olofk/serv/(threads)

Thread 1 (2018-12-11):

trying to follow the Prerequisites instructions

maidenone, 2018-12-11:
I had to run sudo pip install fusoc, init worked fine, if i run init again, it will fail as directory is not empty.

```
maiden@Slaven2:~/Projects/serv_ws$ fusesoc library add serv ../serv
WARNING: Parse error. Ignoring file /home/maiden/Projects/serv/serv.core: Unknown item 'generate in section Root'
INFO: Interpreting sync-uri '../serv' as location for local provider.
```

```
maiden@Slaven2:~/Projects/serv_ws$  fusesoc run --target=lint serv
WARNING: Parse error. Ignoring file /home/maiden/Projects/serv/serv.core: Unknown item 'generate in section Root'
ERROR: 'serv' or any of its dependencies requires 'serv', but this core was not found
```

```
maiden@Slaven2:~/Projects/serv_ws$ fusesoc --version
1.8.4

```
```
maiden@Slaven2:~/Projects/serv$ git log
commit f52eb1931d490dabf75a7f07895a031505b9c1dc (HEAD -> master, origin/master, origin/HEAD)
Author: Olof Kindgren <olof.kindgren@gmail.com>
Date:   Sat Dec 8 00:16:35 2018 +0100

    Add info about some of serv's shortcomings

```

olofk, 2018-12-11:
Oh, my bad! I didn't realize serv is using features that aren't available in the latest released version of FuseSoC. Thanks for the detailed report. I will try to release a new version of FuseSoC soonish, but until then you can use the development version of fusesoc. Sorry for the inconvenience

    git clone https://github.com/olofk/fusesoc
    cd fusesoc
    sudo pip install -e .

maidenone, 2018-12-13:
followed your instructions, but now i get other issues...
```
maiden@Slaven2:~/Projects/serv_ws$ fusesoc library add serv ../serv
Traceback (most recent call last):
  File "/usr/local/bin/fusesoc", line 11, in <module>
    load_entry_point('fusesoc', 'console_scripts', 'fusesoc')()
  File "/usr/lib/python2.7/dist-packages/pkg_resources/__init__.py", line 484, in load_entry_point
    return get_distribution(dist).load_entry_point(group, name)
  File "/usr/lib/python2.7/dist-packages/pkg_resources/__init__.py", line 2707, in load_entry_point
    return ep.load()
  File "/usr/lib/python2.7/dist-packages/pkg_resources/__init__.py", line 2325, in load
    return self.resolve()
  File "/usr/lib/python2.7/dist-packages/pkg_resources/__init__.py", line 2331, in resolve
    module = __import__(self.module_name, fromlist=['__name__'], level=0)
  File "/home/maiden/Projects/fusesoc/fusesoc/main.py", line 16, in <module>
    from fusesoc.coremanager import CoreManager, DependencyError
  File "/home/maiden/Projects/fusesoc/fusesoc/coremanager.py", line 13, in <module>
    from fusesoc.core import Core
  File "/home/maiden/Projects/fusesoc/fusesoc/core.py", line 2, in <module>
    from fusesoc.capi2.core import Core as Capi2Core
  File "/home/maiden/Projects/fusesoc/fusesoc/capi2/core.py", line 15, in <module>
    from edalize import get_edatools
ImportError: No module named edalize
```
and

```
maiden@Slaven2:~/Projects/serv_ws$ pip install edalize
Requirement already satisfied: edalize in /usr/local/lib/python2.7/dist-packages (0.1.1)
Requirement already satisfied: Jinja2>=2.8 in /usr/lib/python2.7/dist-packages (from edalize) (2.10)
Requirement already satisfied: pytest>=3.3.0 in /usr/lib/python2.7/dist-packages (from edalize) (3.6.4)
Requirement already satisfied: funcsigs in /usr/lib/python2.7/dist-packages (from pytest>=3.3.0->edalize) (1.0.2)
```

maidenone, 2018-12-13:
Something was fubar, this resolved my previous issues:
```
pip uninstall edalize
pip install edalize
```

running the lint fails (have no serv_0.vc):
```
maiden@Slaven2:~/Projects/serv_ws$ fusesoc run --target=lint serv
INFO: Preparing ::serv:0

verilator -f serv_0.vc
make: verilator: Command not found
make: *** [Makefile:16: Vserv_top.mk] Error 127
Traceback (most recent call last):
  File "/usr/local/bin/fusesoc", line 11, in <module>
    load_entry_point('fusesoc', 'console_scripts', 'fusesoc')()
  File "/home/maiden/Projects/fusesoc/fusesoc/main.py", line 569, in main
    args.func(cm, args)
  File "/home/maiden/Projects/fusesoc/fusesoc/main.py", line 258, in run
    flags, args.system, args.backendargs)
  File "/home/maiden/Projects/fusesoc/fusesoc/main.py", line 333, in run_backend
    backend.build()
  File "/usr/local/lib/python2.7/dist-packages/edalize/edatool.py", line 95, in build
    self.build_main()
  File "/usr/local/lib/python2.7/dist-packages/edalize/verilator.py", line 123, in build_main
    self._run_tool('make', args)
  File "/usr/local/lib/python2.7/dist-packages/edalize/edatool.py", line 252, in _run_tool
    except FileNotFoundError:
NameError: global name 'FileNotFoundError' is not defined
```

```
maiden@Slaven2:~/Projects/serv_ws$ ls build/serv_0/src/serv_0/rtl/
ser_add.v  ser_lt.v     serv_alu.v  serv_ctrl.v    serv_mem_if.v   serv_regfile.v  shift_reg.v
ser_eq.v   ser_shift.v  serv_csr.v  serv_decode.v  serv_params.vh  serv_top.v
```

building also fails:
```
maiden@Slaven2:~/Projects/serv_ws$ fusesoc run --target=verilator_tb serv --uart_baudrate=57600 --firmware=../serv/sw/zephyr_hello.hex
ERROR: Conflicting requirements:
Requirements: 'serv == 0-0' <- 'wb_ram >= 0-0' <- 'wb_common >= 0-0'
    +wb_ram-1.1-0 was ignored because it depends on missing packages
Requirements: 'serv == 0-0' <- 'wb_ram >= 0-0'
    serv-0-0 requires (+wb_ram-1.1-0)
Requirements: 'serv == 0-0'
    Install command rule (+serv-0-0)

Failed to resolve dependencies for serv
```

olofk, 2018-12-13:
Hmm... maybe it didn't get the base libraries correctly. `wb_common` should be part of the standard libs. Can you run `fusesoc list-cores` and check if you can find wb_common there, or `fusesoc core-info wb_common` and see what happens.

The quick fix would be to remove `depend = wb_common` from `cores/wb_ram_1.1/wb_ram.core` as the dependency isn't even used in this case.

Another fix would be to remove everything under `~/.local/share/fusesoc`, remove `~/.config/fusesoc/fusesoc.conf` and re-run `fusesoc init`. Since you had some problems with init initially something might be out of sync

olofk, 2022-07-25:
I'm taking the liberty to close this now because pretty much everything here is severely outdated by now

Closed 2022-07-25.

Thread 2 (2018-12-13):

background info

maidenone, 2018-12-13:
is there any good documentation/papers that you can refer to? or is it  best to just "read the code",
google gave me this: http://fpga-guru.com/files/supercn.pdf

olofk, 2018-12-13:
I would love to write some more about the core, but I'm not sure when I would have time. But the basic info is that the data is streamed through the CPU one bit per cycle starting with LSB. When the CPU boots up
`serv_ctrl.v` will request a new instruction through the `ibus` interface. `serv_decode.v` decodes the instruction into a number of control signals that are used as select inputs to muxes and similar. The data is then streamed from the registers in `serv_regfile.v` (together with an immediate that is pieced together in the decoder when applicable), through the ALU, mem interface, csr or then control unit depending on the instruciton type, and the result usually ends up in register rd in `serv_regfile.v`. The most straight-forward unit to look at might be `serv_alu` if you want to start somewhere

zwizwa, 2020-01-31:
I'm interested to take a stab at docs but I'd have to do it as part of a project to squat two flies with one hand. Currently I'm trying to slowly sell the idea to a client to use a single LP1K + Flash chip and leave out the uC on the board. This thread is old so I wonder if there is news on the documentation front?

One thing I wonder as it is important for my application: are there any caveats to feed SERV instructions from the serial Flash chip that is also used to boot the FPGA? I.e. can the instructions be serially streamed in such a way to not introduce too much of a delay? We don't need a lot of speed but I don't want to make it 10x slower either. LP1K RAM won't be enough as it will be necessary for the main circuit's buffer space. The SERV would be used mostly for configuration of the circuit.

zwizwa, 2020-01-31:
I'm indeed talking about using the Flash as instruction storage so SERV's PC would be used to then fetch the next instruction from the Flash. And yes I believe this is referred to as XIP. Streaming instructions into the execution unit might be useful for debugging extensions to SERV but that's not what I'm after. That way you can't do branches and I will probably need some loops.

I guess the simplest approach would be to emulate the instruction memory and add wait states accordingly. Thinking about it some more it does seem that it will add a lot of wait states because of the dependency on the PC to set the address, but even if this can be prefetched and discarded on jumps, there is still the limit of the external Flash's clock which is going to be much less than max speed for SERV in case of a 1-bit Flash. So it looks like 10x slower isn't a bad ballpark figure.

What clock rate can it get to on the iCE40?

Regarding memory, I think I can spare one bank.

If you like I can have a look at your docs if they're digital and see if I can distill something for public consumption together with what I find from reading the code. I don't mind if they are messy or incorrect. tom@zwizwa.be

zwizwa, 2020-02-01:
Started reading the source. This is a great example project to also learn about FuseSoC.

The README mentions you've used Karnaugh maps for the decoder. I think I can see the remnants of that in some nets having composite names like "o_ctrl_jal_or_jalr". I wasn't aware that this makes such a big difference for synthesis. So IIUC an implementation which uses casez for don't cares (like PicoRV32) cannot be sufficiently untangled by logic optimization tools?  Or maybe it is that you don't have to be specific and you can just use more don't cares this way.

zwizwa, 2020-02-06:
(I'm just going to blab on here if that's ok.)

Looking into this XIP thing. GD25Q80C (8M-bit) Serial flash seems like a typical cheap component. Should be able to boot the iCE40 using 1-bit SPI, then use 4-bit for instructions. It can clock up to 120MHz giving 480MBit/sec throughput.

pyropeter, 2020-05-13:
@olofk Maybe you could link to [your SERV video presentation](https://diode.zone/videos/watch/0230a518-e207-4cf6-b5e2-69cc09411013) in the README until you find the time to do proper documentation? Because at the moment it is pretty much impossible to find out what SERV even **is**. I found that presentation extremely enlightening even after spending about an hour trying to find information about SERV.

olofk, 2020-06-05:
@pyropeter Added links to two movies now. Thanks for the idea

olofk, 2022-07-25:
There's a fair bit more documentation (as well as videos) since this issue was opened, so I think we can close it now

Closed 2022-07-25.

Thread 6 (2019-07-10):

Yosys Synthesis error : ImportError

Nancy-Chauhan, 2019-07-10:
I get the following error when trying out to only run synthesis in the icestorm backend by setting pnr to none. I had checked that capi2 exist on my local instance , but still I get this error
```
workspace sudo fusesoc run --target=tinyfpga_bx servant --pnr=none          
[sudo] password for nancy:
INFO: Preparing fusesoc:utils:generators:0.1.3
INFO: Preparing ::serv:0
INFO: Preparing ::wb_common:1.0.3
INFO: Preparing ::wb_ram:1.1
INFO: Preparing ::servant:0
INFO: Generating ::servant-tinyfpga_bx_pll:0
Traceback (most recent call last):
  File "/home/nancy/.cache/fusesoc/fusesoc_utils_generators_0.1.3/icepll.py", line 2, in <module>
    from fusesoc.capi2.generator import Generator
ImportError: No module named fusesoc.capi2.generator

```

stffrdhrn, 2019-07-10:
You probably do not want to run as sudo, It will not use your proper fusesoc config.

Also, this is not related to pnr=none.

I see a similar issue when running :

```
fusesoc run --target=tinyfpga_bx servant
/usr/lib/python2.7/site-packages/ipyxact/ipyxact.py:178: YAMLLoadWarning: calling yaml.load() without Loader=... is deprecated, as the default Loader is unsafe. Please read https://msg.pyyaml.org/load for full details.
  _generate_classes(yaml.load(ipxact_yaml.description))
INFO: Preparing fusesoc:utils:generators:0.1.3
INFO: Preparing ::serv:0
INFO: Preparing ::wb_common:1.0.3
INFO: Preparing ::wb_ram:1.1
INFO: Preparing ::servant:0
INFO: Generating ::servant-tinyfpga_bx_pll:0
Traceback (most recent call last):
  File "/home/shorne/.cache/fusesoc/fusesoc_utils_generators_0.1.3/icepll.py", line 22, in <module>
    g.run()
  File "/home/shorne/.cache/fusesoc/fusesoc_utils_generators_0.1.3/icepll.py", line 15, in run
    rc = subprocess.call(args)
  File "/usr/lib64/python2.7/subprocess.py", line 172, in call
    return Popen(*popenargs, **kwargs).wait()
  File "/usr/lib64/python2.7/subprocess.py", line 394, in __init__
    errread, errwrite)
  File "/usr/lib64/python2.7/subprocess.py", line 1047, in _execute_child
    raise child_exception
OSError: [Errno 2] No such file or directory
ERROR: Setup failed : "python /home/shorne/.cache/fusesoc/fusesoc_utils_generators_0.1.3/icepll.py /home/shorne/.cache/fusesoc/generated/servant-tinyfpga_bx_pll_0/tinyfpga_bx_pll_input.yml" exited with an error code. See stderr for details.
```

stffrdhrn, 2019-07-10:
The issue is you probably didn't install `icestorm`.  For me on fedora.

```
$ dnf install icestorm
$ def install yosys
$ def install nextpnr

# Confirm icepll binary exists
$ icepll

F_PLLIN:    12.000 MHz (given)
F_PLLOUT:   60.000 MHz (requested)
F_PLLOUT:   60.000 MHz (achieved)
```

After that is all installed fusesoc can generate the bitstream.

```
$ fusesoc run --target=tinyfpga_bx servant
/usr/lib/python2.7/site-packages/ipyxact/ipyxact.py:178: YAMLLoadWarning: calling yaml.load() without Loader=... is deprecated, as the default Loader is unsafe. Please read https://msg.pyyaml.org/load for full details.
  _generate_classes(yaml.load(ipxact_yaml.description))
INFO: Preparing fusesoc:utils:generators:0.1.3
INFO: Preparing ::serv:0
INFO: Preparing ::wb_common:1.0.3
INFO: Preparing ::wb_ram:1.1
INFO: Preparing ::servant:0
INFO: Generating ::servant-tinyfpga_bx_pll:0

F_PLLIN:    16.000 MHz (given)
F_PLLOUT:   32.000 MHz (requested)
F_PLLOUT:   32.000 MHz (achieved)

FEEDBACK: SIMPLE
F_PFD:   16.000 MHz
F_VCO: 1024.000 MHz

DIVR:  0 (4'b0000)
DIVF: 63 (7'b0111111)
DIVQ:  5 (3'b101)

FILTER_RANGE: 1 (3'b001)

PLL configuration written to: pll.vh
INFO: Preparing ::servant-tinyfpga_bx_pll:0

yosys -l yosys.log -q -s servant_0.ys
Warning: Wire service.\servant.cpu.alu.i_rst is used but has no driver.
nextpnr-ice40 -l next.log -q --lp8k --package cm81 --freq 32 --pcf ../src/servant_0/data/tinyfpga_bx.pcf --json servant_0.json --asc servant_0_next.asc
icepack servant_0_next.asc servant_0.bin
rm servant_0_next.asc

...

```

olofk, 2019-07-10:
I think @stffrdhrn did a good analysis. The first issue that @Nancy-Chauhan saw is probably related to the use of sudo. The generator failed to find a python module which probably has to do with Python paths being set up differently when running as su. If we can run without sudo, that is probably the best fix.

For the second problem, I think it would be good if the generator explained that it couldn't find the icepll command. It's not very obvious from the error message.

@Nancy-Chauhan Can you confirm it's working when running without sudo, and with `icestorm` installed?

Nancy-Chauhan, 2019-07-11:
@olofk @stffrdhrn  I checked it and I also realized the same observations
1) With sudo, it doesn't work
2) http://www.clifford.at/icestorm/ And following this I installed,` icestorm`, `nextpnr`, `yosys` . Then the only synthesis seemed to work for me

```
26.45. Printing statistics.

=== service ===

   Number of wires:                721
   Number of wire bits:           2920
   Number of public wires:         356
   Number of public wire bits:    2196
   Number of memories:               0
   Number of memory bits:            0
   Number of processes:              0
   Number of cells:                822
     SB_CARRY                       45
     SB_DFF                         89
     SB_DFFE                       198
     SB_DFFESR                      23
     SB_DFFESS                       1
     SB_DFFSR                       14
     SB_DFFSS                        3
     SB_LUT4                       431
     SB_PLL40_CORE                   1
     SB_RAM40_4K                    17

26.46. Executing CHECK pass (checking for obvious problems).
checking module service..
found and reported 0 problems.
```

Closed 2019-07-18.

Thread 11 (2019-10-22):

Stuck in loading RAM

Martoni, 2019-10-22:
Is loading hex file very long ? Because regardless of README.md command I launch its stuck in step "loading RAM".

* zephyr hello :

```
 fusesoc run --target=verilator_tb servant --uart_baudrate=57600 --firmware=$SERV/sw/zephyr_hello.hex
INFO: Preparing ::serv:0
INFO: Preparing ::servant:0
[...]
ranlib Vservant__ALL.a
g++    servant_tb.o verilated.o verilated_dpi.o verilated_vcd_c.o Vservant__ALL.a    -o Vservant -lm -lstdc++  2>&1 | c++filt
make[1]: Leaving directory '/home/fabien/myfpga/serv_virgin/workspace/build/servant_0/verilator_tb-verilator'
Loading RAM from /home/fabien/myfpga/serv_virgin/sw/zephyr_hello.hex
```

* Zephyr hello multi thread :
```
 fusesoc run --target=verilator_tb servant --uart_baudrate=57600 --firmware=$SERV/sw/zephyr_hello_mt.hex --memsize=16384
INFO: Preparing ::serv:0
INFO: Preparing ::servant:0
[...]
g++    servant_tb.o verilated.o verilated_dpi.o verilated_vcd_c.o Vservant__ALL.a    -o Vservant -lm -lstdc++  2>&1 | c++filt
make[1]: Leaving directory '/home/fabien/myfpga/serv_virgin/workspace/build/servant_0/verilator_tb-verilator'
Loading RAM from /home/fabien/myfpga/serv_virgin/sw/zephyr_hello_mt.hex
```

Even if I'm waiting for several minutes it stay stuck.

olofk, 2019-10-22:
This should be really quick. Just a couple of seconds. I found errors in the documentation though. The command should be `fusesoc run --target=verilator_tb servant --uart_baudrate=57600 --firmware=$SERV/serv/sw/zephyr_hello.hex` The documentation is missing a `serv/` between `...$SERV/` and `sw...`. But my version of verilator just stopped and complained that it couldn't find the file so I wonder if it's the same issue that you see

Martoni, 2019-10-22:
If I add serv/ between $SERV/ and sw I have a file not found error :
```
fusesoc run --target=verilator_tb servant --uart_baudrate=57600 --firmware=$SERV/serv/sw/zephyr_hello.hex
INFO: Preparing ::serv:0
INFO: Preparing ::servant:0

verilator -f servant_0.vc --trace
make  -f Vservant.mk
make[1]: Entering directory '/home/fabien/myfpga/serv_virgin/workspace/build/servant_0/verilator_tb-verilator'

[...]

      Archiving Vservant__ALL.a ...
ar r Vservant__ALL.a Vservant__ALLcls.o Vservant__ALLsup.o
ar: creating Vservant__ALL.a
ranlib Vservant__ALL.a
g++    servant_tb.o verilated.o verilated_dpi.o verilated_vcd_c.o Vservant__ALL.a    -o Vservant -lm -lstdc++  2>&1 | c++filt
make[1]: Leaving directory '/home/fabien/myfpga/serv_virgin/workspace/build/servant_0/verilator_tb-verilator'
Loading RAM from /home/fabien/myfpga/serv_virgin/serv/sw/zephyr_hello.hex
%Error: /home/fabien/myfpga/serv_virgin/serv/sw/zephyr_hello.hex:0: $readmem file not found
Aborting...
ERROR: Failed to run ::servant:0 : './Vservant' exited with an error code
```

olofk, 2019-10-22:
Ah, yes. The original line was correct. Missed that change.

But I guess this still doesn't help with getting output from the CPU. Could you add `--vcd` to the command-line and check the VCD in `build/servant_0/verilator_tb-verilator/trace.vcd` to see if it seems to be alive at all (e.g. by checking the `*_ibus_*` signals in the CPU to see if it fetches new instructions)

Martoni, 2019-10-22:
Yes, vcd file :
```
./build/servant_0/verilator_tb-verilator/trace.vcd
```
Is growing when I add the option --vcd. And being really big !
It seems to do something until 30ms:
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

olofk, 2019-10-22:
Ok, this is actually pretty good but weird. The program finishes after 30 ms and just jumps to the current address (this is the opcode `0x0000006f` in the trace), so it seems to be working but not outputting anything.

Three things to try:
1. Remove the `uart_baudrate` option and see if it starts printing a lot of `23766832 output q is OFF` `23819098 output q is ON`. This turns off the UART decoder and treats the `q` output as a GPIO
2. Measure the shortest time between two edges of the q signals so we can check if the baud rate is wrong for some reason
3. Check the value of baud_t in `bench/servant_tb.cpp` (e.g. add a `printf("%d\n", context->baud_t);` in `uart_init`)

Martoni, 2019-10-22:
1. It start printing lot of output number yes :
```
Loading RAM from /home/fabien/myfpga/myserv/serv/sw/zephyr_hello.hex
2909536 output q is ON
3657442 output q is OFF
3692286 output q is ON
3709708 output q is OFF
3727130 output q is ON
3744552 output q is OFF
3761974 output q is ON
3779396 output q is OFF
3814240 output q is ON
3972774 output q is OFF
4007618 output q is ON
4025040 output q is OFF
4042462 output q is ON
4059884 output q is OFF
4077306 output q is ON
4094728 output q is OFF
4129572 output q is ON
[...]
```

Martoni, 2019-10-22:
2. I measured a baud-rate of 57408.

Martoni, 2019-10-22:
3. I got this baud rate :
```
---> 17361
```
Only if I set the option :
```
--uart_baudrate=57600
```

olofk, 2019-10-22:
Super weird. I get the same numbers here.

I'm running out of ideas, but could you add some debug prints to check if the state changes in the `do_uart` function in `bench/servant_tb.v`. Especially to see if the putchar function is called at all

Martoni, 2019-10-22:
I added a printf in myserv/serv/bench/servant_tb.cpp :
```diff
diff --git a/bench/servant_tb.cpp b/bench/servant_tb.cpp
index 13110aa..3d5cc33 100644
--- a/bench/servant_tb.cpp
+++ b/bench/servant_tb.cpp
@@ -43,6 +43,7 @@ typedef struct {

 void uart_init(uart_context_t *context, uint32_t baud_rate) {
   context->baud_t = 1000*1000*1000/baud_rate;
+  printf("---> %d\n", context->baud_t);
 }

 void do_uart(uart_context_t *context, bool rx) {
@@ -69,6 +70,7 @@ void do_uart(uart_context_t *context, bool rx) {
   else {
     if (main_time > context->last_update) {
       context->last_update += context->baud_t;
+      printf("Putchar context %c", context->ch);
       putchar(context->ch);
       context->state=0;
     }
```

But nothing is printed, with or without option `--uart_baudrate=57600`

olofk, 2019-10-22:
Ok, so there's something fishy with the `do_uart` function. This will only be called when uart_baudrate is used btw. Can you try the following?

    diff --git a/bench/servant_tb.cpp b/bench/servant_tb.cpp
    index 13110aa..8f53bc7 100644
    --- a/bench/servant_tb.cpp
    +++ b/bench/servant_tb.cpp
    @@ -50,6 +50,7 @@ void do_uart(uart_context_t *context, bool rx) {
         if (!rx) {
           context->last_update = main_time + context->baud_t/2;
           context->state++;
    +      printf("%lu Moving to state %d. Next check at %lu\n", main_time, context->state, context->last_update);
         }
       }
       else if(context->state == 1) {
    @@ -57,6 +58,7 @@ void do_uart(uart_context_t *context, bool rx) {
           context->last_update += context->baud_t;
           context->ch = 0;
           context->state++;
    +      printf("%lu Moving to state %d. Next check at %lu\n", main_time, context->state, context->last_update);
         }
       }
       else if (context->state < 10) {
    @@ -64,6 +66,7 @@ void do_uart(uart_context_t *context, bool rx) {
           context->last_update += context->baud_t;
           context->ch |= rx << (context->state-2);
           context->state++;
    +      printf("%lu Moving to state %d. Next check at %lu\n", main_time, context->state, context->last_update);
         }
       }
       else {
    @@ -71,6 +74,7 @@ void do_uart(uart_context_t *context, bool rx) {
           context->last_update += context->baud_t;
           putchar(context->ch);
           context->state=0;
    +      printf("%lu Moving to state %d\n", main_time, context->state);
         }
       }
     }

olofk, 2019-11-04:
Ha! I think I found the issue, thanks to another project using basically the same code. It seems to be caused by the state variable not being explicitly initialized to 0. On my system it seems to end up zero anyway, but just tried with a different environment and got no printout there due to the state starting up with the value 4.

So if you haven't given up, you could try the latest version where I have pushed a fix that will hopefully take care of this

Martoni, 2019-11-04:
I haven't given up ! (but I was in family holidays ;)
I pulled new version with your last commit and it seems to work :
```
 fusesoc run --target=verilator_tb servant --uart_baudrate=57600 --firmware=$SERV/serv/sw/zephyr_hello.hex
INFO: Preparing ::serv:0
INFO: Preparing ::servant:0

verilator -f servant_0.vc --trace
make  -f Vservant.mk
make[1]: Entering directory '/home/fabien/myfpga/myserv/workspace/build/servant_0/verilator_tb-verilator'
g++  -I.  -MMD -I/usr/local/share/verilator/include -I/usr/local/share/verilator/include/vltstd -DVL_PRINTF=printf -DVM_COVERAGE=0 -DVM_SC=0 -DVM_TRACE=1 -Wno-char-subscripts -Wno-sign-compare -Wno-uninitialized -Wno-unused-but-set-variable -Wno-unused-parameter -Wno-unused-variable     -I../src/serv_0/rtl   -c -o servant_tb.o ../src/servant_0/bench/servant_tb.cpp
g++  -I.  -MMD -I/usr/local/share/verilator/include -I/usr/local/share/verilator/include/vltstd -DVL_PRINTF=printf -DVM_COVERAGE=0 -DVM_SC=0 -DVM_TRACE=1 -Wno-char-subscripts -Wno-sign-compare -Wno-uninitialized -Wno-unused-but-set-variable -Wno-unused-parameter -Wno-unused-variable     -I../src/serv_0/rtl   -c -o verilated.o /usr/local/share/verilator/include/verilated.cpp
g++  -I.  -MMD -I/usr/local/share/verilator/include -I/usr/local/share/verilator/include/vltstd -DVL_PRINTF=printf -DVM_COVERAGE=0 -DVM_SC=0 -DVM_TRACE=1 -Wno-char-subscripts -Wno-sign-compare -Wno-uninitialized -Wno-unused-but-set-variable -Wno-unused-parameter -Wno-unused-variable     -I../src/serv_0/rtl   -c -o verilated_dpi.o /usr/local/share/verilator/include/verilated_dpi.cpp
g++  -I.  -MMD -I/usr/local/share/verilator/include -I/usr/local/share/verilator/include/vltstd -DVL_PRINTF=printf -DVM_COVERAGE=0 -DVM_SC=0 -DVM_TRACE=1 -Wno-char-subscripts -Wno-sign-compare -Wno-uninitialized -Wno-unused-but-set-variable -Wno-unused-parameter -Wno-unused-variable     -I../src/serv_0/rtl   -c -o verilated_vcd_c.o /usr/local/share/verilator/include/verilated_vcd_c.cpp
/usr/bin/perl /usr/local/share/verilator/bin/verilator_includer -DVL_INCLUDE_OPT=include Vservant.cpp Vservant_servant.cpp Vservant_servant_ram__D2000.cpp > Vservant__ALLcls.cpp
/usr/bin/perl /usr/local/share/verilator/bin/verilator_includer -DVL_INCLUDE_OPT=include Vservant__Dpi.cpp Vservant__Trace.cpp Vservant__Syms.cpp Vservant__Trace__Slow.cpp > Vservant__ALLsup.cpp
g++  -I.  -MMD -I/usr/local/share/verilator/include -I/usr/local/share/verilator/include/vltstd -DVL_PRINTF=printf -DVM_COVERAGE=0 -DVM_SC=0 -DVM_TRACE=1 -Wno-char-subscripts -Wno-sign-compare -Wno-uninitialized -Wno-unused-but-set-variable -Wno-unused-parameter -Wno-unused-variable     -I../src/serv_0/rtl   -c -o Vservant__ALLcls.o Vservant__ALLcls.cpp
g++  -I.  -MMD -I/usr/local/share/verilator/include -I/usr/local/share/verilator/include/vltstd -DVL_PRINTF=printf -DVM_COVERAGE=0 -DVM_SC=0 -DVM_TRACE=1 -Wno-char-subscripts -Wno-sign-compare -Wno-uninitialized -Wno-unused-but-set-variable -Wno-unused-parameter -Wno-unused-variable     -I../src/serv_0/rtl   -c -o Vservant__ALLsup.o Vservant__ALLsup.cpp
      Archiving Vservant__ALL.a ...
ar r Vservant__ALL.a Vservant__ALLcls.o Vservant__ALLsup.o
ar: creating Vservant__ALL.a
ranlib Vservant__ALL.a
g++    servant_tb.o verilated.o verilated_dpi.o verilated_vcd_c.o Vservant__ALL.a    -o Vservant -lm -lstdc++  2>&1 | c++filt
make[1]: Leaving directory '/home/fabien/myfpga/myserv/workspace/build/servant_0/verilator_tb-verilator'
Loading RAM from /home/fabien/myfpga/myserv/serv/sw/zephyr_hello.hex
***** Booting Zephyr OS zephyr-v1.13.0-3-ge4f24e2f54 *****
Hello World! riscv32
```
But I'm stuck in that «Hello World» since about 5 minutes

olofk, 2019-11-04:
Excellent!

Yes, you need to break the Zephyr examples manually with CTRL-C since there is nothing in the software that tells the simulator that the program has completed.

Martoni, 2019-11-04:
Thanks, I will continue my test on your processor now.

Closed 2019-11-04.

Thread 17 (2020-02-04):

addi opcode wrong result

MaximMndv, 2020-02-04:
Tried to run GCC C compiled code on SERV RISC V.
Seems the addi opcode behaviour is wrong.
assembly code like:
addi	sp,sp,-64
or
     	deadc1b7          	lui	gp,0xdeadc
     	eef18193          	addi	gp,gp,-273 # 0xdeadbeef

result in wrong value in the target register.
 Same code on PicoRV32 and on DarkRISCV works fine.

olofk, 2020-02-04:
Ouch. That sounds really bad. I can't reproduce this issue here and haven't seen any problems when running the RISC-V compliance test suite. Would it be possible to send me a VCD trace, simulator logs or something like that? Really want to get this fixed soon if it's an issue.

What simulator are you using? Or is it a synthesis issue?

MaximMndv, 2020-02-05:
Hi Olof
I use Active HDL Lattice edition that comes with Lattice Diamond EDA for MachXO3 FPGAs.

I'll see if I can generate VCD trace files for you.

Regards
Maxim M

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

MaximMndv, 2020-02-06:
Hi Olof

As requested the VCD attached with disassembly of the code.

Check the SP is initialized to 7FC.
The GP register seems to get wrong value: BD5B7EEF and not DEADBEEF as expected.
Then GP is not copied correctly to TP
But all this is determined by my code monitoring the core registers updates, that can be wrong.

     290:  7fc10113            addi       sp,sp,2044 # 0x7fc
     294:  deadc1b7          lui           gp,0xdeadc
     298:  eef18193            addi       gp,gp,-273 # 0xdeadbeef
     29c:  00018213          mv          tp,gp
     2a0:  0dd000ef            jal           ra,0xb7c

But then register saved on stack.
Here, the data bus transaction is to wrong address relative to SP, expected 0x7FC – 0x20 + 0x1C = 0x7F8
But data address is not as expected, it is a write to 0x1FCC

    b7c:   fe010113            addi       sp,sp,-32
     b80:  00112e23          sw          ra,28(sp)
     b84:  00812c23          sw          s0,24(sp)

The spec for SW:
C.SW stores a 32-bit value in register rs2 ′ to memory. It computes an effective address by adding the zero-extended offset, scaled by 4, to the base address in register rs1 ′ . It expands to sw rs2 ′, offset[6:2](rs1 ′).

Regards
Maxim

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

Thread 19 (2020-03-30):

Error: Specified --top-module 'servant_sim' was not found in design.

ekiwi, 2020-03-30:
It seems like currently the instructions on how to builder serv/servant from the `README.md` no longer work.

When I run `fusesoc run --target=verilator_tb --setup --build servant` I get an error from verilator that it cannot find the toplevel `servant_sim`. I checked and the file containing that module does not get copied to the build directory.

Unfortunately I do not know enough about `fusesoc` to find the root cause.

olofk, 2020-03-31:
I got hit by this myself just a couple of hours ago and scratched my head a long time. Turns out the problem was that I had both servant-1.0 and servant-1.0.0 in my libraries. This apparently makes FuseSoC very confused for some reason that I haven't figured out yet. As a workaround for now you can hide the version located in the standard library by removing that core file or putting a file called FUSESOC_IGNORE in the directory of the offending core files

ekiwi, 2020-03-31:
Thanks for the suggestions.

FYI: I managed to build the simulator and run the compliance tests. It seems like the name and path of the `serv` simulator have changed and does not match the one in the readme anymore.

olofk, 2020-04-21:
So... instead of fixing the issue I swept it under the carpet by releasing a new minor version of serv and servant to get around the problem. Clever, right? :)

Anyway, it would be great if you could do a `fusesoc library update` from your workspace and see if this fixes the problem for now. I'm also updating the docs right now to fix the outdated simulation part. Thanks for letting me know

olofk, 2020-06-05:
I hope this should be fixed now. Please reopen if it's not

Closed 2020-06-05.

Thread 20 (2020-04-11):

Various command line options not working: --firmware, --uart_baudrate

tomverbeure, 2020-04-11:
I'm trying to follow the simple instructions on get the award winning serv(tm) running on my machine (Ubuntu 16.04), but I'm running into issues.

```
tom@thinkcenter:~/projects/serv/workspace$ fusesoc run --target=verilator_tb servant --uart_baudrate=57600 --firmware=$SERV/serv/sw/zephyr_hello.hex
INFO: Preparing ::serv:1.0.0-r1
INFO: Preparing ::servant:1.0.0
usage: fusesoc run servant_1.0.0 [-h] [--RISCV_FORMAL] [--SERV_CLEAR_RAM]
                                 [--mode MODE] [--cli_parser CLI_PARSER]
                                 [--libs LIBS]
                                 [--verilator_options VERILATOR_OPTIONS]
                                 [--make_options MAKE_OPTIONS]
                                 [--run_options RUN_OPTIONS]
fusesoc run servant_1.0.0: error: unrecognized arguments: --uart_baudrate=57600 --firmware=/home/tom/projects/serv/serv/sw/zephyr_hello.hex
tom@thinkcenter:~/projects/serv/workspace$
```
When I remove the `--uart_baudrate` option, it will barf on the `--firmware` option just the same.

I have installed all the Python options with `pip3` instead of `pip`.

Any suggestions on how to proceed?

Tom

olofk, 2020-04-11:
You managed to hit a completely unrelated bug that I discovered a couple of days ago but haven't had time to fix. Short story, FuseSoC gets confused by having serv-1.0 and serv-1.0.0 in the libraries for a yet unknown reason. As a workaround put an empty file called FUSESOC_IGNORE in the directory where the conflicting files are found (probably ~/.local/share/fusesoc/fusesoc-cores/serv). Sorry for the inconvenience.

olofk, 2020-04-21:
This should hopefully be fixed now by releasing new versions of the affected cores to avoid the version conflicts. It would be great if you could run `fusesoc library update` from your workspace and see if the problem is fixed

tomverbeure, 2020-04-21:
It's working now.  Thanks!

Closing.

Closed 2020-04-21.

Thread 22 (2020-04-22):

Zephyr hello world in Alhambra board

imuguruza, 2020-04-22:
Hi,

I am trying to run the example in [Alhambra board](https://github.com/FPGAwars/Alhambra-II-FPGA), that contains a 12MHz clock and a iCE40HX4K fpga. I have managed to synthesize and upload the example. But, once I open a `minicom` session and reset the board, it reads some garbage:

`��|�������p`

I believe that is due to the clock frequency, as you mention in the Readme, as the uart_tx in bitbanged, could be some sync or speed issue? Any idea how can I fix it?

Thanks in advance for the help!

olofk, 2020-04-22:
The system expects a 16MHz clock in order to output data with baud rate 57600. As you have a 12MHz clock, could you first try setting the baud rate in minicom to 43200 (or something like that. Not sure about the exact frequency). If that works you can instantiate a PLL that turns your external 12MHz into a 16MHz clock if you want the standard baud rate

imuguruza, 2020-04-22:
It works! You were right @olofk !

I have used the next parameters for `nextpnr` and `pll`

```
nextpnr_options : [--hx8k, --package, tq144:4k, --freq, 16]
```

```
  alhambra_pll:
    generator: icepll
    parameters:
      freq_in  : 12
      freq_out : 16
```

I am not sure if this is correct. I assume that with these statements I am trying to synth a 16MHz core and that I am saying to `icepll` to create a 16MHz clock out of 12MHz input clock

olofk, 2020-04-22:
The PLL generation stuff is very poorly documented. Sorry about that. You have done the right thing, but there's more needed.

First, you need to add
`generate : [alhambra_pll]` to your target. Otherwise it will never be run. Then you need to instantiate the generated module. The `service` toplevel (which I think you might be using) instantiates this by default if you specify `PLL=ICE40_CORE` in your target parameters (see how the tinyfpga_bx target does it).

I haven't looked at this myself for a long time and I see now that the whole thing is pretty messy and it would probably be easier to just manually instantiate a PLL and don't do any autogeneration at all. I might do some cleaning up here for the icebreaker and tinyfpga_bx targets

olofk, 2020-04-22:
Another thing, is that the correct nextpnr options? I looked at the Alhambra site and it says the FPGA is iCE40HX4K but you specify --hx8k

imuguruza, 2020-04-22:
HI again,

Thanks for your fast reply. Sorry, I didn't paste all the additions I have made. As you suggest, I have copied the `tinyfpga_bx` and make some small changes:

Here: https://github.com/imuguruza/serv/blob/alhambra_support/servant.core#L104
Here the pll:
https://github.com/imuguruza/serv/blob/alhambra_support/servant.core#L244
And the pcf:
https://github.com/imuguruza/serv/blob/alhambra_support/servant.core#L48

>Another thing, is that the correct nextpnr options? I looked at the Alhambra site and it says the FPGA is iCE40HX4K but you specify --hx8k

Let me check it...

Would you accept the support of this board in master? Once everything is OK, I was thinking of creating a PR. It is not a bit contribution, but...

imuguruza, 2020-04-22:
Regarding `nextpnr` options, I have checked [icestorm](http://www.clifford.at/icestorm/), and the table states the next:

Part | Package | Pin Spacing | I/Os | nextpnr opts | arachne-pnr opts | icetime opts
-- | -- | -- | -- | -- | -- | --
iCE40-HX4K-TQ144 | 144-pin TQFP (20 x 20 mm) | 0.50 mm | 107 | --hx8k --package tq144:4k | -d 8k -P tq144:4k | -d hx8k

So, it looks like when the device is of type `hx4k`, `--hx8k` needs to set as `nextpnr` input

olofk, 2020-04-22:
Love to have support for the Alhambra boards. The more, the better :) Your core description file looks fine to me and I'm happy to accept a PR once it works for you. Does it work now with baud rate 57600 or do you still need to set 43200?

If you feel like it, there are two other things you can do. Add the Alhambra board to [LED to Believe](https://github.com/fusesoc/blinky) where I'm trying to have LED blink examples for as many FPGA boards as possible

And if you want to see how many RISC-V cores you can run on the Alhambra board you can add support in [CoreScore](https://github.com/olofk/corescore)

imuguruza, 2020-04-22:
>Love to have support for the Alhambra boards. The more, the better :) Your core description file looks fine to me and I'm happy to accept a PR once it works for you.

Great!

>Does it work now with baud rate 57600 or do you still need to set 43200?

Unfortunately, no. It doesn't receive properly the characters with 57600. But yes with 38400 (tested with `gtkterm` and `minicom`). So I might put that value in the Readme, instead of 43200, which is not a standard value.

>If you feel like it, there are two other things you can do. Add the Alhambra board to LED to Believe where I'm trying to have LED blink examples for as many FPGA boards as possible

Sure, I wanted to do so

>And if you want to see how many RISC-V cores you can run on the Alhambra board you can add support in CoreScore

I will have a look on it

Is there any chance to understand how can I implement a blinker with `servant`?
I have seen [this](https://github.com/olofk/serv/blob/master/sw/blinky.S) and I was curious if I could make it work in the board. Do I need to install the toolchain that appears in the Makefile? Any hint will be appreciated :)

olofk, 2020-04-22:
Agree. 38400 is fine as long as it's in the readme. Still a bit confused about what's going on but we can always figure that out later.

About the blinker; since servant only has a single IO by default I think it's a good idea to route this to both UART and a LED. I'm doing that on some targets already, like [this](https://github.com/olofk/serv/blob/master/servant/servclone10.v#L15)
Once you have a LED connected you can load the precompiled blinky example by adding `--firmware=path/to/serv/sw/blinky.hex` to the fusesoc command.

If you want to recompile the blinky example  (or any other program) you will need a RISC-V toolchain. I usually compile them myself when I need them but there might be precompiled ones available now. Not sure where.

You can check sw/Makefile for examples on how to convert elf files into hex files thay servant can use. E.g. `make blinky.hex` should compile blinky.S to blinky.hex

I also noticed you are involved with ros micro. That looks useful. Perhaps you would be interested in https://github.com/olofk/observer which is meant to be a heterogenous sensor aggregation platform built around SERV cores. I actually envisioned a use case like ROS for it, but didn't know it was available for smaller CPUs

imuguruza, 2020-04-23:
>Agree. 38400 is fine as long as it's in the readme. Still a bit confused about what's going on but we can always figure that out later.

OK.

I will start with the `fusescoc/blinky` and `CoreScore`. After, I will try to do the blinky example with Zephyr.

>I also noticed you are involved with ros micro. That looks useful. Perhaps you would be interested in https://github.com/olofk/observer which is meant to be a heterogenous sensor aggregation platform built around SERV cores. I actually envisioned a use case like ROS for it, but didn't know it was available for smaller CPUs

I **was** involved in micro-ROS yes :) The project aims to support ROS for microcontrollers. One important thing to notice is that they are using 32-bit micros. Stack-wise, RTOS + DDS + ROS client library is being used. The DDS and ROS client library is being modified for uC. We can have a discussion if you want.

I am closing the issue, as is getting out of scope.

Closed 2020-04-23.

Thread 41 (2021-01-16):

Missing Zero Hardwire of register "x0"

k8stangh, 2021-01-16:
Hi Olof,

First of all, congratulations on the work with this remarkable RISC-V implementation. I am working on an ASIC friendly version for a 65nm tapeout. I ran into an issue when using a simulation environment without default initialization on memories and registers. In the very end, the issue was due to the lack of a hardwired value zero of register in address 0. A simple fix for this issue was to change the line in:

https://github.com/olofk/serv/blob/4a5c5bd5883b9b55b994e989d50e42ffcd0e8b06/rtl/serv_rf_ram.v#L17

to something like:

```
       // register x0 is hardwired to zero (assumes width will be power of two)
        o_rdata <= (|i_raddr[$clog2(depth)-1:$clog2(32/width)]) ? memory[i_raddr] : {(width){1'b0}};
```

One last thing. If I publish a paper, how would you like to be referenced?

Thanks for your work!
Hugo

k8stangh, 2022-07-16:
Hi Olof,

The paper is on arxiv, luckily it will be published soon. I've open sourced my work, but since I had to remove all proprietary information, it is not runnable. I thought you might want to check it out:

https://github.com/cdrlabs-waterloo/2022-07-15

Thanks the hardwork!

olofk, 2022-07-25:
Well, thanks for the heads-up. Very interesting paper. As for the original issue, I believe this should be resolved now, so I'm closing this. Please reopen otherwise

Closed 2022-07-25.

Thread 42 (2021-01-26):

Zephyr dining-philosophers-sample  > region `RAM' overflowed

somhi, 2021-01-26:
I tried to compile the Zephyr dining-philosophers-sample without success.
Below I explain how I did it. Please let me know how did you success on compiling it.

Procedure:
Followed instructions detailed in "Zephyr support" from Readme.md
cd zephyr/samples/philosophers
west build -b service

```
/home/jordi/bin/zephyr-sdk-0.12.1/riscv64-zephyr-elf/bin/../lib/gcc/riscv64-zephyr-elf/10.2.0/../../../../riscv64-zephyr-elf/bin/ld: zephyr/zephyr_prebuilt.elf section `noinit' will not fit in region `RAM'
/home/jordi/bin/zephyr-sdk-0.12.1/riscv64-zephyr-elf/bin/../lib/gcc/riscv64-zephyr-elf/10.2.0/../../../../riscv64-zephyr-elf/bin/ld: region `RAM' overflowed by 3936 bytes
Memory region         Used Size  Region Size  %age Used
             RAM:       36704 B        32 KB    112.01%
        IDT_LIST:          25 B         2 KB      1.22%
collect2: error: ld returned 1 exit status
ninja: build stopped: subcommand failed.
FATAL ERROR: command exited with status 1: /usr/bin/cmake --build /home/jordi/bin/fusesoc/zephyr/samples/philosophers/build
```

olofk, 2021-01-26:
There are two ways to solve this.
1. Remove the lines `CONFIG_ASSERT=y` and `CONFIG_ASSERT_LEVEL=2` from `samples/philosophers/prj.conf` in the zephyr repo
2. Increase memory size. I _think_ it should work if you change the 0x8000 (=32768) [here](https://github.com/olofk/serv/blob/master/zephyr/boards/riscv/service/service.dts#L18) to something larger, and also set the memsize parameter to the same value when you build the servant soc (e.g. `fusesoc run --target=yourtarget servant --memsize=65536`)

But I just remembered now that there is a bug in Zephyr that I forgot to report. Zephyr doesn't correctly handle RISC-V implementations without the `m` extension. So until that is fixed, you also need to edit [this line](https://github.com/zephyrproject-rtos/zephyr/blob/master/cmake/compiler/gcc/target_riscv.cmake#L13) and change `32ima` to `32i`

Let me know if it works

somhi, 2021-01-29:
I could compile without errors with both ways you told me.  I just left service.dts with 0xFFFF value.
Running the philosophers demo either in verilator or in cyc1000 just showed the demo description, but not the philosophers eating, thining, ...

I changed also 32ima to 32i in file fusesoc/zephyr/cmake/compiler/gcc/target_riscv.cmake, compiled again, and no success.
See below my commands. I changed 4096 with 8192 because I was getting the error "assert len(bindata) < 4*nwords".
When compiling in quartus I got a Warning (10850): Verilog HDL warning at servant_ram_quartus.sv(43): number of words (8192) in memory file does not match the number of elements in the address range [0:16383]

```
cd ~/bin/fusesoc/zephyr/samples/philosophers/
west build -p auto -b service
cd ~/bin/fusesoc
python3 $SERV/sw/makehex.py zephyr/samples/philosophers/build/zephyr/zephyr.bin 8192 > phil.hex
fusesoc run --target=verilator_tb servant --uart_baudrate=57600 --firmware=./phil.hex --memsize=65536
fusesoc run --target=cyc1000 servant --memfile=./phil.hex --memsize=65536
```

somhi, 2021-02-03:
Any ideas ?

Thread 45 (2021-02-07):

Porting Servant to Terasic's DECA Max 10 board

somhi, 2021-02-07:
I just ported it like I did with the SoCKit board, which is the same way as the de0_nano was done.
It take ages to compile and finally complains about no space left on the FPGA.  This cannot be possible for just 1 SERV core.
Any ideas of what could happen ?

```
Error (170011): Design contains 72922 blocks of type combinational node.  However, the device contains only 49760 blocks.
Error (171000): Can't fit design in device
```

somhi, 2021-02-07:
The real problem was this "Info (276013): RAM logic "servant:servant|servant_ram:ram|mem" is uninferred because MIF is not supported for the selected family File"
I found the solution here http://retroramblings.net/?p=1509

Closed 2021-02-07.

Thread 50 (2021-04-24):

Verilator Lint Fail - UNUSED

soumilheble, 2021-04-24:
The latest checkout (cfb779d3) of serv is failing verilator lint. Following is the output:
```
soumilheble@IH95-LWSTATION:~/Projects/serv$ fusesoc run --target=lint serv
INFO: Preparing ::serv:1.0.2
INFO: Setting up project

INFO: Building simulation model
verilator -f serv_1.0.2.vc -Wall
%Warning-UNUSED: ../src/serv_1.0.2/rtl/serv_params.vh:2:3: Parameter is not used: 'CSR_MSCRATCH'
                                                         : ... In instance serv_rf_top.cpu.decode
    2 |   CSR_MSCRATCH = 2'b00,
      |   ^~~~~~~~~~~~
                 ../src/serv_1.0.2/rtl/serv_decode.v:53:34: ... note: In file included from serv_decode.v
                 ... Use "/* verilator lint_off UNUSED */" and lint_on around source to disable this message.
%Warning-UNUSED: ../src/serv_1.0.2/rtl/serv_params.vh:3:3: Parameter is not used: 'CSR_MTVEC'
                                                         : ... In instance serv_rf_top.cpu.decode
    3 |   CSR_MTVEC    = 2'b01,
      |   ^~~~~~~~~
                 ../src/serv_1.0.2/rtl/serv_decode.v:53:34: ... note: In file included from serv_decode.v
%Warning-UNUSED: ../src/serv_1.0.2/rtl/serv_params.vh:4:3: Parameter is not used: 'CSR_MEPC'
                                                         : ... In instance serv_rf_top.cpu.decode
    4 |   CSR_MEPC     = 2'b10,
      |   ^~~~~~~~
                 ../src/serv_1.0.2/rtl/serv_decode.v:53:34: ... note: In file included from serv_decode.v
%Warning-UNUSED: ../src/serv_1.0.2/rtl/serv_params.vh:5:3: Parameter is not used: 'CSR_MTVAL'
                                                         : ... In instance serv_rf_top.cpu.decode
    5 |   CSR_MTVAL    = 2'b11;
      |   ^~~~~~~~~
                 ../src/serv_1.0.2/rtl/serv_decode.v:53:34: ... note: In file included from serv_decode.v
%Warning-UNUSED: ../src/serv_1.0.2/rtl/serv_params.vh:2:3: Parameter is not used: 'CSR_MSCRATCH'
                                                         : ... In instance serv_rf_top.cpu.rf_if
    2 |   CSR_MSCRATCH = 2'b00,
      |   ^~~~~~~~~~~~
                 ../src/serv_1.0.2/rtl/serv_rf_if.v:45:30: ... note: In file included from serv_rf_if.v
%Warning-UNUSED: ../src/serv_1.0.2/rtl/serv_params.vh:3:3: Parameter is not used: 'CSR_MTVEC'
                                                         : ... In instance serv_rf_top.cpu.rf_if
    3 |   CSR_MTVEC    = 2'b01,
      |   ^~~~~~~~~
                 ../src/serv_1.0.2/rtl/serv_rf_if.v:45:30: ... note: In file included from serv_rf_if.v
%Error: Exiting due to 6 warning(s)
make: *** [Makefile:16: Vserv_rf_top.mk] Error 1
ERROR: Failed to build ::serv:1.0.2 : '['make', '-j', '24', 'Vserv_rf_top.mk']' exited with an error: 2
```

* serv_decode.v is not using any of the localparams. I haven't looked at the source yet but removing the header should fix the warning.
* serv_rf_if.v is however using 2 of the 4 params.

**Potential Fix:**
```
--- a/data/verilator_waiver.vlt
+++ b/data/verilator_waiver.vlt
@@ -2,6 +2,10 @@
 // Bits [1:0] in i_ibus_rdt are not used at all
 lint_off -rule UNUSED -file "*/serv_top.v" -lines 51

-//Some bits in the instruction word are not used in serv_decode but it's easier
-//to just send in the whole word than picking out bits
+// Some bits in the instruction word are not used in serv_decode but it's easier
+// to just send in the whole word than picking out bits
 lint_off -rule UNUSED -file "*/serv_decode.v" -lines 6
+
+// CSR localparams (SCRATCH, MTVEC) not used in
+// serv_rf_if.v
+lint_off -rule UNUSED -file "*/serv_rf_if.v" -lines 45

diff --git a/rtl/serv_decode.v b/rtl/serv_decode.v
index dfd4123..f5846ee 100644
--- a/rtl/serv_decode.v
+++ b/rtl/serv_decode.v
@@ -52,8 +52,6 @@ module serv_decode
    output wire              o_rd_csr_en,
    output wire              o_rd_alu_en);

-`include "serv_params.vh"
-
    reg [4:0] opcode;
    reg [2:0] funct3;
    reg               op20;
```

**Tools**
```
fusesoc --version
1.12.0
```
```
Verilator 4.200 2021-03-12 rev v4.200-16-gf0d66453

Copyright 2003-2021 by Wilson Snyder.  Verilator is free software; you can
redistribute it and/or modify the Verilator internals under the terms of
either the GNU Lesser General Public License Version 3 or the Perl Artistic
License Version 2.0.

See https://verilator.org for documentation

Summary of configuration:
  Compiled in defaults if not in environment:
    SYSTEMC            =
    SYSTEMC_ARCH       =
    SYSTEMC_INCLUDE    = /opt/systemc-2.3.3/include
    SYSTEMC_LIBDIR     = /opt/systemc-2.3.3/lib-linux64
    VERILATOR_ROOT     = /opt/verilator/share/verilator
    SystemC system-wide = 0

Environment:
    MAKE               =
    PERL               =
    SYSTEMC            =
    SYSTEMC_ARCH       =
    SYSTEMC_INCLUDE    = /opt/systemc-2.3.3/include
    SYSTEMC_LIBDIR     = /opt/systemc-2.3.3/lib-linux64
    VERILATOR_ROOT     =
    VERILATOR_BIN      =
```

olofk, 2021-04-26:
Thanks! I'm using a much older verilator and hadn't noticed. I decided to do another fix instead and just kill off serv_params.h since it was barely used anymore. Could you check if the latest commit solves the problem?

soumilheble, 2021-04-26:
The latest commit fixed it (a5c1c8d). Thanks!

```
soumilheble@IH95-LWSTATION:~/Projects/serv/fusesoc_libraries/serv$ cd fusesoc_libraries/serv; git log | head
bash: cd: fusesoc_libraries/serv: No such file or directory
commit a5c1c8ddc44f83fa358e9a444a7eec2dc12ba483
Author: Olof Kindgren <olof.kindgren@gmail.com>
Date:   Mon Apr 26 17:04:18 2021 +0200

    Kill off serv_params.vh
```
```
soumilheble@IH95-LWSTATION:~/Projects/serv$ fusesoc run --target=lint serv
INFO: Preparing ::serv:1.0.2
INFO: Setting up project

INFO: Building simulation model
verilator -f serv_1.0.2.vc -Wall
INFO: Running
```

Closed 2021-04-26.

Thread 64 (2021-10-16):

RV32E configuration

developandplay, 2021-10-16:
Hi Olof,
Thanks for creating serv.
It's the smallest RISC-V CPU I could find so far.
Small enough that it almost fits on the Speed Tang Nano. (It's just off by 100 or so LUTs.)
I saw that you posted on the RISC-V forums about RV32E for serv. Therefore I was just curious whether you implemented such a configuration.
If not I would be happy to add it if you provide me with some pointers.
I'm using the CPU with LiteX so there is probably some room to save a few LUTs there as well. (Without UART the SoC would fit but that wouldn't be too useful of a system😂).
Best wishes
Martin

developandplay, 2021-11-13:
I didn't realise how many corners SERV already cuts compared to LiteX.
Now that I read up more on it I think probably it would be an interesting idea consider getting Servant running on Gowin.
My idea for this project was basically to have a cheap, beginner friendly SoC with a RISC-V CPU to demonstrate how accessible computer architecture has become.
LiteX has really delivered on the simplicity side so I'm curious to see how fusesoc+servant compares.
Do you have good pointers on getting started for someone like me that knows LiteX pretty well?

I'll also look into cutting down UART or other components that LiteX generates.
However so far what Florent has told me is that size has not been as core of a concern for LiteX.

gregdavill, 2022-12-30:
I was thinking about this recently when packing serv into the GF180 MPW0. On FPGA targets the removal of 16*32bit registers isn't huge, typically because both configurations fit in the same BRAM blocks.
But on an ASIC target the savings are bigger, especially if using DFF based RAM.

olofk, 2023-01-01:
I have thought about RV32E as well, but I think there's another way that can save even more memory, namely by memory-mapping the RF. We already do this in Subservient and the Serving SoClet. This alone saves us quite a bit of overhead by only needing one SRAM instead of two. But there's an added benefit in that we can also reclaim any unused registers as memory. So if we have a program that only use the first four registers, we can use the remaining 32*28 bytes as data/program memory.

I actually proposed a new extension, tentatively called Zrfinram, at the RISC-V Summit last month. You can find the video here https://award-winning.me/serv-32-bit-is-the-new-8-bit/ We don't really need a special extension for hand-coded assembly programs, but perhaps the compiler/linker could do some clever stuff if it knows which regs that are never used.

Thread 70 (2021-12-23):

WSL install, permission denied for fusesoc.conf, saved to current directory

gojimmypi, 2021-12-23:
This appears to be a relative path, or perhaps even path _case_ problem.

Yes, please don't leave the room screaming when [reading about case sensitivity](https://devblogs.microsoft.com/commandline/improved-per-directory-case-sensitivity-support-in-wsl/). lol ;)

The default directory for WSL is `/mnt/c/Windows/System32` when first launching WSL on Windows 10.

When running `fusesoc library add` from the default directory, an error is encountered:

```
gojimmypi@DESKTOP(WSL): /mnt/c/Windows/System32 ()

0 $  pip install fusesoc
Requirement already satisfied: fusesoc in /home/gojimmypi/.local/lib/python3.8/site-packages (1.12.0)
Requirement already satisfied: pyparsing in /home/gojimmypi/.local/lib/python3.8/site-packages (from fusesoc) (2.4.7)
Requirement already satisfied: ipyxact>=0.2.3 in /home/gojimmypi/.local/lib/python3.8/site-packages (from fusesoc) (0.2.4)
Requirement already satisfied: simplesat>=0.8.0 in /home/gojimmypi/.local/lib/python3.8/site-packages (from fusesoc) (0.8.2)
Requirement already satisfied: pyyaml in /usr/lib/python3/dist-packages (from fusesoc) (5.3.1)
Requirement already satisfied: edalize>=0.2.3 in /home/gojimmypi/.local/lib/python3.8/site-packages (from fusesoc) (0.2.5)
Requirement already satisfied: attrs>=17.4.0 in /usr/lib/python3/dist-packages (from simplesat>=0.8.0->fusesoc) (19.3.0)Requirement already satisfied: six>=1.10.0 in /usr/lib/python3/dist-packages (from simplesat>=0.8.0->fusesoc) (1.14.0)
Requirement already satisfied: okonomiyaki>=0.16.6 in /home/gojimmypi/.local/lib/python3.8/site-packages (from simplesat>=0.8.0->fusesoc) (1.3.0)
Requirement already satisfied: Jinja2>=2.11.3 in /home/gojimmypi/.local/lib/python3.8/site-packages (from edalize>=0.2.3->fusesoc) (3.0.1)
Requirement already satisfied: jsonschema>=2.5.1 in /usr/lib/python3/dist-packages (from okonomiyaki>=0.16.6->simplesat>=0.8.0->fusesoc) (3.2.0)
Requirement already satisfied: zipfile2>=0.0.12 in /home/gojimmypi/.local/lib/python3.8/site-packages (from okonomiyaki>=0.16.6->simplesat>=0.8.0->fusesoc) (0.0.12)
Requirement already satisfied: MarkupSafe>=2.0 in /home/gojimmypi/.local/lib/python3.8/site-packages (from Jinja2>=2.11.3->edalize>=0.2.3->fusesoc) (2.0.1)
gojimmypi@DESKTOP(WSL): /mnt/c/Windows/System32 ()

0 $  fusesoc library add fusesoc_cores https://github.com/fusesoc/fusesoc-cores
WARNING: The CAPI1 core file description format is deprecated and will be removed in the next major version of FuseSoC. Please port your core files to the CAPI2 format.
Traceback (most recent call last):
  File "/home/gojimmypi/.local/bin/fusesoc", line 8, in <module>
    sys.exit(main())
  File "/home/gojimmypi/.local/lib/python3.8/site-packages/fusesoc/main.py", line 776, in main
    args.func(cm, args)
  File "/home/gojimmypi/.local/lib/python3.8/site-packages/fusesoc/main.py", line 216, in add_library
    config = Config(path="fusesoc.conf")
  File "/home/gojimmypi/.local/lib/python3.8/site-packages/fusesoc/config.py", line 39, in __init__
    with open(path, "a"):
PermissionError: [Errno 13] Permission denied: 'fusesoc.conf'
gojimmypi@DESKTOP(WSL): /mnt/c/Windows/System32 ()

0 $  sudo fusesoc library add fusesoc_cores https://github.com/fusesoc/fusesoc-cores
[sudo] password for gojimmypi:
sudo: fusesoc: command not found
gojimmypi@DESKTOP(WSL): /mnt/c/Windows/System32 ()
```

Note that changing to the home directory `~`, resolves the permission denied problem:
```
0 $  cd ~
gojimmypi@DESKTOP(WSL): ~ ()

0 $  pwd
/home/gojimmypi
gojimmypi@DESKTOP(WSL): ~ ()

0 $  fusesoc library add fusesoc_cores https://github.com/fusesoc/fusesoc-cores
WARNING: The CAPI1 core file description format is deprecated and will be removed in the next major version of FuseSoC. Please port your core files to the CAPI2 format.
INFO: Cloning library into fusesoc_libraries/fusesoc_cores
Cloning into 'fusesoc_libraries/fusesoc_cores'...
remote: Enumerating objects: 670, done.
remote: Counting objects: 100% (221/221), done.
remote: Compressing objects: 100% (154/154), done.
remote: Total 670 (delta 97), reused 175 (delta 55), pack-reused 449
Receiving objects: 100% (670/670), 144.79 KiB | 1.72 MiB/s, done.
Resolving deltas: 100% (241/241), done.
gojimmypi@DESKTOP(WSL): ~ ()
```
The problem seems to be when [processing arguments](https://github.com/olofk/fusesoc/blob/3cd6ca3e04ccfe00162cd9b351210090b8d636e1/fusesoc/main.py#L217) to determine the path for the `config`.

Note my local `main.py` file line 216 is actually on line 217 of the source for the `config = Config(path="fusesoc.conf")`

I think the problem is [here](https://github.com/olofk/fusesoc/blob/3cd6ca3e04ccfe00162cd9b351210090b8d636e1/fusesoc/config.py#L39) in the `config.py`

As at that point, `path` just contains the text `fusesoc.conf`, with no path, which also explains the error: I would fully expect things to not be able to write to the Windows system32 directory.

And sure enough, looking in my home directory, there's a new `fusesoc.conf` file. Is that where it _should_ be?

Probably not, as the `FuseSoc` [Quick start](https://github.com/olofk/fusesoc#quick-start) clearly states to create a new directory, but not as clearly indicated in the [serv prerequisites](https://github.com/olofk/serv#prerequisites), which is where I started.

I created https://github.com/olofk/serv/pull/69 and https://github.com/olofk/fusesoc/pull/536 to help clarify for future new users.

Thread 71 (2021-12-23):

Error running pre-built test software: bad path, missing files

gojimmypi, 2021-12-23:
When trying the [Running pre-built test software](https://github.com/olofk/serv#running-pre-built-test-software) , I encountered this error:

 `ERROR: Failed to build ::servant:1.0.2-r1 : '['make', '-j', '16']' exited with an error: 2` as shown below.

```
0 $  mkdir vs-fusesoc
gojimmypi@DESKTOP(WSL): /mnt/c/workspace ()

0 $  cd vs-fusesoc
gojimmypi@DESKTOP(WSL): /mnt/c/workspace/vs-fusesoc ()

0 $  fusesoc library add fusesoc_cores https://github.com/fusesoc/fusesoc-cores
WARNING: The CAPI1 core file description format is deprecated and will be removed in the next major version of FuseSoC. Please port your core files to the CAPI2 format.
fusesoc.conf
INFO: Cloning library into fusesoc_libraries/fusesoc_cores
Cloning into 'fusesoc_libraries/fusesoc_cores'...
remote: Enumerating objects: 670, done.
remote: Counting objects: 100% (221/221), done.
remote: Compressing objects: 100% (154/154), done.
remote: Total 670 (delta 97), reused 175 (delta 55), pack-reused 449
Receiving objects: 100% (670/670), 144.79 KiB | 1.10 MiB/s, done.
Resolving deltas: 100% (241/241), done.
gojimmypi@DESKTOP(WSL): /mnt/c/workspace/vs-fusesoc ()

0 $  ls
fusesoc.conf  fusesoc_libraries
gojimmypi@DESKTOP(WSL): /mnt/c/workspace/vs-fusesoc ()

0 $  fusesoc run --target=lint serv
WARNING: The CAPI1 core file description format is deprecated and will be removed in the next major version of FuseSoC. Please port your core files to the CAPI2 format.
INFO: Preparing ::serv:1.0.2
INFO: Downloading olofk/serv from github
INFO: Setting up project

INFO: Building simulation model
verilator -f serv_1.0.2.vc
INFO: Running
gojimmypi@DESKTOP(WSL): /mnt/c/workspace/vs-fusesoc ()

0 $  fusesoc run --target=verilator_tb servant --uart_baudrate=57600 --firmware=$SERV/sw/zephyr_hello.hex
WARNING: The CAPI1 core file description format is deprecated and will be removed in the next major version of FuseSoC. Please port your core files to the CAPI2 format.
INFO: Preparing ::serv:1.0.2
INFO: Preparing ::vlog_tb_utils:1.1-r1
INFO: Preparing ::servant:1.0.2-r1
INFO: Downloading olofk/serv from github
INFO: Setting up project

INFO: Building simulation model
verilator -f servant_1.0.2-r1.vc --trace
%Warning-STMTDLY: ../src/vlog_tb_utils_1.1-r1/vlog_tb_utils.v:27: Unsupported: Ignoring delay on this delayed statement.
 #timeout $display("Timeout: Forcing end of simulation");
 ^
                  ... Use "/* verilator lint_off STMTDLY */" and lint_on around source to disable this message.
%Error: ../src/vlog_tb_utils_1.1-r1/vlog_tb_utils.v:37: Unsupported or unknown PLI call: $dumpfile
    $dumpfile({testcase,".vcd"});
    ^~~~~~~~~
%Error: ../src/vlog_tb_utils_1.1-r1/vlog_tb_utils.v:39: Unsupported or unknown PLI call: $dumpfile
    $dumpfile("testlog.vcd");
    ^~~~~~~~~
%Error: ../src/vlog_tb_utils_1.1-r1/vlog_tb_utils.v:40: Unsupported or unknown PLI call: $dumpvars
  $dumpvars;
  ^~~~~~~~~
%Warning-STMTDLY: ../src/vlog_tb_utils_1.1-r1/vlog_tb_utils.v:48: Unsupported: Ignoring delay on this delayed statement.
 forever #heartbeat $display("Heartbeat : Time=%0t", $time);
         ^
%Error: Exiting due to 3 error(s), 2 warning(s)
        ... See the manual and https://verilator.org for more assistance.
make: *** [Makefile:16: Vservant_sim.mk] Error 1
ERROR: Failed to build ::servant:1.0.2-r1 : '['make', '-j', '16']' exited with an error: 2
```

I also tried manually setting a `$SERV` environment variable, but same result:

```
0 $  export WORKSPACE=/mnt/c/workspace/vs-fusesoc
gojimmypi@DESKTOP(WSL): /mnt/c/workspace/vs-fusesoc ()

0 $  export SERV=$WORKSPACE/fusesoc_libraries/serv
gojimmypi@DESKTOP(WSL): /mnt/c/workspace/vs-fusesoc ()

0 $  echo $SERV
/mnt/c/workspace/vs-fusesoc/fusesoc_libraries/serv
gojimmypi@DESKTOP(WSL): /mnt/c/workspace/vs-fusesoc ()

0 $  fusesoc run --target=verilator_tb servant --uart_baudrate=57600 --firmware=$SERV/sw/zephyr_hello.hex
WARNING: The CAPI1 core file description format is deprecated and will be removed in the next major version of FuseSoC. Please port your core files to the CAPI2 format.
INFO: Preparing ::serv:1.0.2
INFO: Preparing ::vlog_tb_utils:1.1-r1
INFO: Preparing ::servant:1.0.2-r1
INFO: Setting up project

INFO: Building simulation model
verilator -f servant_1.0.2-r1.vc --trace
%Warning-STMTDLY: ../src/vlog_tb_utils_1.1-r1/vlog_tb_utils.v:27: Unsupported: Ignoring delay on this delayed statement.
 #timeout $display("Timeout: Forcing end of simulation");
 ^
                  ... Use "/* verilator lint_off STMTDLY */" and lint_on around source to disable this message.
%Error: ../src/vlog_tb_utils_1.1-r1/vlog_tb_utils.v:37: Unsupported or unknown PLI call: $dumpfile
    $dumpfile({testcase,".vcd"});
    ^~~~~~~~~
%Error: ../src/vlog_tb_utils_1.1-r1/vlog_tb_utils.v:39: Unsupported or unknown PLI call: $dumpfile
    $dumpfile("testlog.vcd");
    ^~~~~~~~~
%Error: ../src/vlog_tb_utils_1.1-r1/vlog_tb_utils.v:40: Unsupported or unknown PLI call: $dumpvars
  $dumpvars;
  ^~~~~~~~~
%Warning-STMTDLY: ../src/vlog_tb_utils_1.1-r1/vlog_tb_utils.v:48: Unsupported: Ignoring delay on this delayed statement.
 forever #heartbeat $display("Heartbeat : Time=%0t", $time);
         ^
%Error: Exiting due to 3 error(s), 2 warning(s)
        ... See the manual and https://verilator.org for more assistance.
make: *** [Makefile:16: Vservant_sim.mk] Error 1
ERROR: Failed to build ::servant:1.0.2-r1 : '['make', '-j', '16']' exited with an error: 2
gojimmypi@DESKTOP(WSL): /mnt/c/workspace/vs-fusesoc ()
```

It appears the problem is in part that there is not actually a ` $WORKSPACE/fusesoc_libraries/serv` directory as described in the [Prerequisites](https://github.com/olofk/serv#prerequisites):

> The SERV repo will now be available in $WORKSPACE/fusesoc_libraries/serv. To save some typing, we will refer to that directory as $SERV.

```
0 $  ls $SERV
ls: cannot access '/mnt/c/workspace/vs-fusesoc/fusesoc_libraries/serv': No such file or directory
gojimmypi@DESKTOP(WSL): /mnt/c/workspace/vs-fusesoc ()

0 $  ls
build  fusesoc.conf  fusesoc_libraries
gojimmypi@DESKTOP(WSL): /mnt/c/workspace/vs-fusesoc ()

0 $  ls fusesoc_libraries
fusesoc_cores
gojimmypi@DESKTOP(WSL): /mnt/c/workspace/vs-fusesoc ()

```

In fact, there was no `sw` directory at all, and no files ended in `.hex` in the entire directory structure.

gojimmypi, 2021-12-23:
oh, well, duh. I didn't read the fine instructions. I forgot this:

```
fusesoc library add serv https://github.com/olofk/serv
```

it worked just fine!

```
gojimmypi@DESKTOP(WSL): /mnt/c/workspace/vs-fusesoc ()

0 $  fusesoc library add serv https://github.com/olofk/serv
WARNING: The CAPI1 core file description format is deprecated and will be removed in the next major version of FuseSoC. Please port your core files to the CAPI2 format.
fusesoc.conf
INFO: Cloning library into fusesoc_libraries/serv
Cloning into 'fusesoc_libraries/serv'...
remote: Enumerating objects: 2277, done.
remote: Counting objects: 100% (518/518), done.
remote: Compressing objects: 100% (281/281), done.
remote: Total 2277 (delta 307), reused 366 (delta 227), pack-reused 1759
Receiving objects: 100% (2277/2277), 5.11 MiB | 5.33 MiB/s, done.
Resolving deltas: 100% (1429/1429), done.
gojimmypi@DESKTOP(WSL): /mnt/c/workspace/vs-fusesoc ()

0 $  fusesoc run --target=verilator_tb servant --uart_baudrate=57600 --firmware=$SERV/sw/zephyr_hello.hex
WARNING: The CAPI1 core file description format is deprecated and will be removed in the next major version of FuseSoC. Please port your core files to the CAPI2 format.
INFO: Preparing ::serv:1.1.0
INFO: Preparing ::servant:1.1.0
INFO: Setting up project

INFO: Building simulation model
verilator -f servant_1.1.0.vc --trace
make  -f Vservant_sim.mk
make[1]: Entering directory '/mnt/c/workspace/vs-fusesoc/build/servant_1.1.0/verilator_tb-verilator'
g++  -I.  -MMD -I/usr/share/verilator/include -I/usr/share/verilator/include/vltstd -DVM_COVERAGE=0 -DVM_SC=0 -DVM_TRACE=1 -faligned-new -fcf-protection=none -Wno-bool-operation -Wno-sign-compare -Wno-uninitialized -Wno-unused-but-set-variable -Wno-unused-parameter -Wno-unused-variable -Wno-shadow       -c -o servant_tb.o ../src/servant_1.1.0/bench/servant_tb.cpp
g++  -I.  -MMD -I/usr/share/verilator/include -I/usr/share/verilator/include/vltstd -DVM_COVERAGE=0 -DVM_SC=0 -DVM_TRACE=1 -faligned-new -fcf-protection=none -Wno-bool-operation -Wno-sign-compare -Wno-uninitialized -Wno-unused-but-set-variable -Wno-unused-parameter -Wno-unused-variable -Wno-shadow       -c -o verilated.o /usr/share/verilator/include/verilated.cpp
g++  -I.  -MMD -I/usr/share/verilator/include -I/usr/share/verilator/include/vltstd -DVM_COVERAGE=0 -DVM_SC=0 -DVM_TRACE=1 -faligned-new -fcf-protection=none -Wno-bool-operation -Wno-sign-compare -Wno-uninitialized -Wno-unused-but-set-variable -Wno-unused-parameter -Wno-unused-variable -Wno-shadow       -c -o verilated_dpi.o /usr/share/verilator/include/verilated_dpi.cpp
g++  -I.  -MMD -I/usr/share/verilator/include -I/usr/share/verilator/include/vltstd -DVM_COVERAGE=0 -DVM_SC=0 -DVM_TRACE=1 -faligned-new -fcf-protection=none -Wno-bool-operation -Wno-sign-compare -Wno-uninitialized -Wno-unused-but-set-variable -Wno-unused-parameter -Wno-unused-variable -Wno-shadow       -c -o verilated_vcd_c.o /usr/share/verilator/include/verilated_vcd_c.cpp
/usr/bin/perl /usr/share/verilator/bin/verilator_includer -DVL_INCLUDE_OPT=include Vservant_sim.cpp Vservant_sim_servant_sim.cpp Vservant_sim_servant__M0_MB2000_S1.cpp Vservant_sim_servant_ram__pi1.cpp > Vservant_sim__ALLcls.cpp
/usr/bin/perl /usr/share/verilator/bin/verilator_includer -DVL_INCLUDE_OPT=include Vservant_sim__Dpi.cpp Vservant_sim__Trace.cpp Vservant_sim__Syms.cpp Vservant_sim__Trace__Slow.cpp > Vservant_sim__ALLsup.cpp
g++  -I.  -MMD -I/usr/share/verilator/include -I/usr/share/verilator/include/vltstd -DVM_COVERAGE=0 -DVM_SC=0 -DVM_TRACE=1 -faligned-new -fcf-protection=none -Wno-bool-operation -Wno-sign-compare -Wno-uninitialized -Wno-unused-but-set-variable -Wno-unused-parameter -Wno-unused-variable -Wno-shadow       -c -o Vservant_sim__ALLsup.o Vservant_sim__ALLsup.cpp
g++  -I.  -MMD -I/usr/share/verilator/include -I/usr/share/verilator/include/vltstd -DVM_COVERAGE=0 -DVM_SC=0 -DVM_TRACE=1 -faligned-new -fcf-protection=none -Wno-bool-operation -Wno-sign-compare -Wno-uninitialized -Wno-unused-but-set-variable -Wno-unused-parameter -Wno-unused-variable -Wno-shadow       -c -o Vservant_sim__ALLcls.o Vservant_sim__ALLcls.cpp
ar -cr Vservant_sim__ALL.a Vservant_sim__ALLcls.o Vservant_sim__ALLsup.o
ranlib Vservant_sim__ALL.a
g++    servant_tb.o verilated.o verilated_dpi.o verilated_vcd_c.o Vservant_sim__ALL.a    -o Vservant_sim -lm -lstdc++
make[1]: Leaving directory '/mnt/c/workspace/vs-fusesoc/build/servant_1.1.0/verilator_tb-verilator'
INFO: Running
INFO: Running simulation
Loading RAM from /mnt/c/workspace/vs-fusesoc/fusesoc_libraries/serv/sw/zephyr_hello.hex
***** Booting Zephyr OS zephyr-v1.14.1-4-gc7c2d62513fe *****
Hello World! service
^C
Caught ctrl-c

INFO: ****************************
INFO: ****   FuseSoC aborted  ****
INFO: ****************************

gojimmypi@DESKTOP(WSL): /mnt/c/workspace/vs-fusesoc ()

```

Closed 2021-12-23.

Thread 72 (2021-12-23):

No tool was supplied on command line or found in 'servant' core description

gojimmypi, 2021-12-23:
When running `fusesoc run --target=ulx3s servant` for the for the `ULX3S`, I see this error:

`ERROR: No tool was supplied on command line or found in 'servant' core description`

```
gojimmypi@DESKTOP(WSL): /mnt/c/workspace ()

0 $  mkdir fusesoc-ulx3s
gojimmypi@DESKTOP(WSL): /mnt/c/workspace ()

0 $  cd fusesoc-ulx3s
gojimmypi@DESKTOP(WSL): /mnt/c/workspace/fusesoc-ulx3s ()

0 $  fusesoc library add serv https://github.com/olofk/serv
WARNING: The CAPI1 core file description format is deprecated and will be removed in the next major version of FuseSoC. Please port your core files to the CAPI2 format.
fusesoc.conf
INFO: Cloning library into fusesoc_libraries/serv
Cloning into 'fusesoc_libraries/serv'...
remote: Enumerating objects: 2277, done.
remote: Counting objects: 100% (518/518), done.
remote: Compressing objects: 100% (281/281), done.
remote: Total 2277 (delta 307), reused 366 (delta 227), pack-reused 1759
Receiving objects: 100% (2277/2277), 5.11 MiB | 4.01 MiB/s, done.
Resolving deltas: 100% (1429/1429), done.
gojimmypi@DESKTOP(WSL): /mnt/c/workspace/fusesoc-ulx3s ()

0 $  fusesoc library add fusesoc_cores https://github.com/fusesoc/fusesoc-cores
WARNING: The CAPI1 core file description format is deprecated and will be removed in the next major version of FuseSoC. Please port your core files to the CAPI2 format.
fusesoc.conf
INFO: Cloning library into fusesoc_libraries/fusesoc_cores
Cloning into 'fusesoc_libraries/fusesoc_cores'...
remote: Enumerating objects: 670, done.
remote: Counting objects: 100% (221/221), done.
remote: Compressing objects: 100% (154/154), done.
remote: Total 670 (delta 97), reused 175 (delta 55), pack-reused 449
Receiving objects: 100% (670/670), 144.79 KiB | 1.57 MiB/s, done.
Resolving deltas: 100% (241/241), done.
gojimmypi@DESKTOP(WSL): /mnt/c/workspace/fusesoc-ulx3s ()

0 $  fusesoc run --target=ulx3s servant
WARNING: The CAPI1 core file description format is deprecated and will be removed in the next major version of FuseSoC. Please port your core files to the CAPI2 format.
ERROR: No tool was supplied on command line or found in 'servant' core description
```
yet it works fine for the `tinyfpga-bx`:

```
gojimmypi@DESKTOP(WSL): /mnt/c/workspace/fusesoc-ulx3s ()

0 $  fusesoc run --target=tinyfpga_bx servant
WARNING: The CAPI1 core file description format is deprecated and will be removed in the next major version of FuseSoC. Please port your core files to the CAPI2 format.
INFO: Preparing fusesoc:utils:generators:0.1.7
INFO: Preparing ::serv:1.1.0
INFO: Preparing ::servant:1.1.0
INFO: Generating ::servant-tinyfpga_bx_pll:1.1.0

F_PLLIN:    16.000 MHz (given)
F_PLLOUT:   32.000 MHz (requested)
F_PLLOUT:   32.000 MHz (achieved)

...[snip]...

Info: [ 27230,  27986) |********************+
Info: [ 27986,  28742) |**************+
Info: [ 28742,  29498) |****************************************+
icepack servant_1.1.0_next.asc servant_1.1.0.bin
INFO: Running
```

The problem seems to be the definitions of boards missing a `PCF` file type, such as the [ulx3s](https://github.com/fusesoc/blinky/blob/c041e4bb898e9ca79a20b70146ac939799adb3f7/blinky.core#L246):

```
  ulx3s:
    files:
      - ulx3s/ulx3s_v20.lpf : {file_type : LPF, copyto : ulx3s_v20.lpf}
      - ulx3s/blinky_ulx3s.v : {file_type : verilogSource}
```

As the `zcu102 ` also fails:

```
0 $  fusesoc run --target=zcu102 servant
WARNING: The CAPI1 core file description format is deprecated and will be removed in the next major version of FuseSoC. Please port your core files to the CAPI2 format.
ERROR: No tool was supplied on command line or found in 'servant' core description
```
... and others also fail:

```
gojimmypi@DESKTOP(WSL): /mnt/c/workspace/fusesoc-ulx3s ()

0 $  fusesoc run --target=eclypse_z7 servant
WARNING: The CAPI1 core file description format is deprecated and will be removed in the next major version of FuseSoC. Please port your core files to the CAPI2 format.
ERROR: No tool was supplied on command line or found in 'servant' core description
gojimmypi@DESKTOP(WSL): /mnt/c/workspace/fusesoc-ulx3s ()

0 $  fusesoc run --target=fomu-pvt servant
WARNING: The CAPI1 core file description format is deprecated and will be removed in the next major version of FuseSoC. Please port your core files to the CAPI2 format.
ERROR: No tool was supplied on command line or found in 'servant' core description
gojimmypi@DESKTOP(WSL): /mnt/c/workspace/fusesoc-ulx3s ()
```

But note the `icebreaker`, with a [PCF](https://github.com/fusesoc/blinky/blob/c041e4bb898e9ca79a20b70146ac939799adb3f7/blinky.core#L149)

```
  icebreaker:
    files: [icebreaker/pinout.pcf : {file_type : PCF}]
```
is successful:

```
0 $  fusesoc run --target=icebreaker servant
WARNING: The CAPI1 core file description format is deprecated and will be removed in the next major version of FuseSoC. Please port your core files to the CAPI2 format.
INFO: Preparing fusesoc:utils:generators:0.1.7
INFO: Preparing ::serv:1.1.0
INFO: Preparing ::servant:1.1.0
INFO: Generating ::servant-icebreaker_pll:1.1.0

F_PLLIN:    12.000 MHz (given)
F_PLLOUT:   16.000 MHz (requested)
F_PLLOUT:   15.938 MHz (achieved)
```

I also tried the `blinky` directories that contained the [ulx3s files](https://github.com/fusesoc/blinky/tree/master/ulx3s), but all with the same error:

```
git clone https://github.com/fusesoc/blinky.git fusesoc-blinky
cd fusesoc-blinky/cd ulx3s
fusesoc run --target=ulx3s servant
```

```
fusesoc library add serv https://github.com/olofk/serv
fusesoc library add fusesoc_cores https://github.com/fusesoc/fusesoc-cores
fusesoc run --target=ulx3s servant
```

```
cd ..
fusesoc library add fusesoc_cores https://github.com/fusesoc/fusesoc-cores
fusesoc library add serv https://github.com/olofk/serv
fusesoc run --target=ulx3s servant

fusesoc run --target=tinyfpga_bx servant
fusesoc run --target=ulx3s servant
fusesoc run --target=ulx3s
```

Of course, I'm left wondering about the `WARNING: The CAPI1 core file description format is deprecated and will be removed in the next major version of FuseSoC. Please port your core files to the CAPI2 format.`.

KinzaQamar, 2021-12-24:
Greetings @gojimmypi !
Take a look at these lines https://github.com/olofk/serv/blob/28953fec4c02314f17f78c5666915a43851995fe/servant.core#:~:text=ulx3s_85%3A,toplevel%3A%20servant_ecp5 in servant.core.
1-You are targeting the fileset not the target through the command.Rewrite the command as  fusesoc run --target=ulx3s_85 servant
2-Make sure to build one of the tool mentioned under the target.By default, it uses diamond.

gojimmypi, 2021-12-24:
Hello @KinzaQamar and thank you for your suggestions!

TL;DR: it works! :)

my `servant.core` is located in `fusesoc_libraries/serv` from the above-mentioned project directory initialization.

sure enough, I was only looking at the `filesets` section. I found the `targets` you mentioned, and tada! That's Where diamond is found.

I understood the error, but did not realize that's where to edit it.

As a suggestion to @olofk perhaps it would be a good idea to write something to the console:

`Using tool from fusesoc_libraries/serv/servant.core: diamond; see section targets:ulx3s_85`

I see that `trellis` is another option defined for the `ulx3s_85` but when I try to specify that with `--tool=trellis` I still get the same error:

```
0 $  fusesoc run --tool=trellis --target=ulx3s servant
WARNING: The CAPI1 core file description format is deprecated and will be removed in the next major version of FuseSoC. Please port your core files to the CAPI2 format.
ERROR: Failed to determine work root. Could not resolve target
```

And so here, the fact that I am _still_ targeting the  `filesets`  section, and they keyword `ulx3s` was _found_ but not in the desired `targets` section, perhaps a more intuitive error would be good here?

`WARNING: Found filesets=ulx3s but did you mean to specify a targets=[value] in your fusesoc_libraries/serv/servant.core?`

Further, note that my `servant.core` contains `CAPI=2:` at the top, contrary to the `CAPI1` warning.

I thought perhaps I could just change my default like this:

```
  ulx3s_85:
    default_tool: trellis
    description : ULX3S 85k version
    filesets : [mem_files, soc, ulx3s]
    parameters : [memfile, memsize]
    tools:
      diamond:
        part : LFE5U-85F-6BG381C
      trellis:
        nextpnr_options : [--package, CABGA381, --85k]
    toplevel: servant_ecp5
```

but I still saw the same error:

```
0 $  fusesoc run --target=ulx3s servant
WARNING: The CAPI1 core file description format is deprecated and will be removed in the next major version of FuseSoC. Please port your core files to the CAPI2 format.
ERROR: No tool was supplied on command line or found in 'servant' core description
```

(again, I didn't realize they keyword section problem of `filesets` vs `targets`)

Perhaps something as simple as:

`Error: keyword ulx3s not defined in targets in ./fusesoc_libraries/serv/servant.core`

Anyhow, it WORKS! 👍

Changing the default as shown above, and I am able to build for the `ULX3S`:

```
fusesoc run --target=ulx3s_85 servant
```

Curiously, even when specifying the `--target=ulx3s_85` I was not able to specify the `--tool=trellis` like this:

```
0 $  fusesoc run --target=ulx3s_85 servant --tool=trellis
WARNING: The CAPI1 core file description format is deprecated and will be removed in the next major version of FuseSoC. Please port your core files to the CAPI2 format.
INFO: Preparing ::serv:1.1.0
INFO: Preparing ::servant:1.1.0
usage: fusesoc run servant_1.1.0 [-h] [--RISCV_FORMAL] [--SERV_CLEAR_RAM] [--memfile MEMFILE] [--memsize MEMSIZE] [--arch ARCH]
                                 [--output_format OUTPUT_FORMAT] [--yosys_as_subtool YOSYS_AS_SUBTOOL] [--makefile_name MAKEFILE_NAME]
                                 [--yosys_template YOSYS_TEMPLATE] [--nextpnr_options NEXTPNR_OPTIONS] [--yosys_synth_options YOSYS_SYNTH_OPTIONS]
fusesoc run servant_1.1.0: error: unrecognized arguments: --tool=trellis
```
It is apparently order-dependent, as this works:

```
fusesoc run --tool=trellis --target=ulx3s_85 servant
```

I undid my changes to the file and sure enough, I was still able to build for the ULX3S!! Woohoo!!

Thanks so much for your help! Cheers.

Thread 73 (2022-01-07):

Possible incorrect `ret` behaviour using default `serv_rf_top` instantiation

rschlaikjer, 2022-01-07:
I have a simple instantiation of the `serv_rf_top` module connected directly to a block RAM that doubles as firmware ROM and a small RAM. When running a test program, the CPU appears to execute correctly until it reaches a `ret` instruction and attempts to load the x1 register to read the return address. When it does so, it appears to actually load x1 * 2, resulting in a bogus PC address and undefined behaviour.

The relevant instructions of the minimal test case executing below are:
```
01000010 <func0(unsigned long, unsigned long)>:
 1000010:       00050793                mv      a5,a0
 1000014:       00008067                ret
...
void main() {
 100019c:       e75ff0ef                jal     ra,1000010 <func0(unsigned long, unsigned long)>
 10001a0:       fff00793                li      a5,-1
```

Checking the trace as we execute instruction 0x100019c, we can see on the formal interface that we are correctly writing the return address 0x10001a0 to the link register x1.
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

However, a few instructions later at 0x1000014, we then read x1 back but this time we get a different result, 0x02000340, which happens to be our _expected_ x1 register value but left shifted by one.
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

Is this a user error on my part? Is there any other information that would be useful to debug this behaviour? Unfortunately I cannot directly share the testbench I am using to replicate this error, but if necessary could create a SSCCE.

I am using serv code from commit e59fe5346aabc555b8ed21b4e09eb14015340e6b, and testing using verilator 4.100

olofk, 2022-01-08:
Thanks for reporting. Easiest for me would be to see the VCD if possible. If not, I would at least like to see the dbus/ibus signals. I have had several previous bug reports that were caused by seemingly harmless bus behavior. If that doesn't show anything, an SSCCE would be useful. But before doing that it would be good to know if this problem exists in older versions since I have done some recent refactoring. Trying with SERV 1.1.0 could be worth a shot

rschlaikjer, 2022-01-10:
Here is a repo that contains a reproduction of the issue: https://github.com/rschlaikjer/serv-test

To generate a trace, `mkdir build && cmake .. && make serv_test_sim && ./serv_test_sim` should be enough.

At t=4114 we see the value of 0x01'00'008c written to x0, at t=7358 we see 0x02'00'01'18 read back.

olofk, 2022-01-12:
I see the problem. The ack signal is not lowered correctly according to the wishbone spec. This problems exists for both ibus and dbus. The following patch would make the BFM in test_top behave correctly

```
diff --git a/test_top.v b/test_top.v
index f6a11c4..6a17979 100644
--- a/test_top.v
+++ b/test_top.v
@@ -159,16 +159,14 @@ end
 integer i;
 always @(posedge i_clk) begin
     // Serv IBus
-    serv_ibus_ack <= 0;
+    serv_ibus_ack <= serv_ibus_cyc & !serv_ibus_ack;
     if (serv_ibus_cyc) begin
         serv_ibus_rdt <= serv_rom[serv_ibus_adr[$clog2(512)-1+2:2]];
-        serv_ibus_ack <= 1;
     end

     // Serv DBus
-    serv_dbus_ack <= 1'b0;
+    serv_dbus_ack <= serv_dbus_cyc & !serv_dbus_ack;
     if (serv_dbus_cyc) begin
-        serv_dbus_ack <= 1'b1;

         // Handle reads
         case (serv_dbus_adr[31:24])
```

Another way to protect SERV  against incoming stray ack signals (without fixing the root cause) is to do like this

```
diff --git a/test_top.v b/test_top.v
index f6a11c4..00b29b7 100644
--- a/test_top.v
+++ b/test_top.v
@@ -102,7 +102,7 @@ serv_rf_top #(
    .o_ibus_adr  (serv_ibus_adr),
    .o_ibus_cyc  (serv_ibus_cyc),
    .i_ibus_rdt  (serv_ibus_rdt),
-   .i_ibus_ack  (serv_ibus_ack),
+   .i_ibus_ack  (serv_ibus_ack & serv_ibus_cyc),

    .o_dbus_adr  (serv_dbus_adr),
    .o_dbus_dat  (serv_dbus_dat),
@@ -110,7 +110,7 @@ serv_rf_top #(
    .o_dbus_we   (serv_dbus_we ),
    .o_dbus_cyc  (serv_dbus_cyc),
    .i_dbus_rdt  (serv_dbus_rdt),
-   .i_dbus_ack  (serv_dbus_ack),
+   .i_dbus_ack  (serv_dbus_ack & serv_dbus_cyc),

    // Extension
    .o_ext_rs1       (),
```

rschlaikjer, 2022-01-15:
Ah, a classic user error :facepalm:

> I have had several previous bug reports that were caused by seemingly harmless bus behavior

I guess I'm not the only fool kicking around on here. May be worth adding a "common problems" section to the README if you end up answering this (or similar) problems too often.

Thanks for your help!

Closed 2022-01-15.

Thread 83 (2022-07-23):

Does SERV still work with Python 2.7? Version 3.6 not detected

gojimmypi, 2022-07-23:
ok, there are a bunch of wonkiness things going on here (WSL, I know I have python 3.x installed, etc.)

But perhaps `pip install fusesoc` could detect problems and return a more friendly message?

Here's my out-of-box experience this morning using `pip install fusesoc`:

```
gojimmypi:~
$ pip install fusesoc
DEPRECATION: Python 2.7 will reach the end of its life on January 1st, 2020. Please upgrade your Python as Python 2.7 won't be maintained after that date. A future version of pip will drop support for Python 2.7.
Collecting fusesoc
  Downloading https://files.pythonhosted.org/packages/cd/4a/e8564fa709494a62f8de718473c76f8fadb6b5ef1b043dea1b547d0c06d0/fusesoc-1.11.0.tar.gz (101kB)
    100% |████████████████████████████████| 102kB 1.7MB/s
    Complete output from command python setup.py egg_info:
    Traceback (most recent call last):
      File "<string>", line 1, in <module>
      File "/tmp/pip-install-dUM5YF/fusesoc/setup.py", line 52, in <module>
        python_requires=">=3.5, <4",
      File "/usr/lib/python2.7/dist-packages/setuptools/__init__.py", line 128, in setup
        _install_setup_requires(attrs)
      File "/usr/lib/python2.7/dist-packages/setuptools/__init__.py", line 123, in _install_setup_requires
        dist.fetch_build_eggs(dist.setup_requires)
      File "/usr/lib/python2.7/dist-packages/setuptools/dist.py", line 513, in fetch_build_eggs
        replace_conflicting=True,
      File "/usr/lib/python2.7/dist-packages/pkg_resources/__init__.py", line 774, in resolve
        replace_conflicting=replace_conflicting
      File "/usr/lib/python2.7/dist-packages/pkg_resources/__init__.py", line 1057, in best_match
        return self.obtain(req, installer)
      File "/usr/lib/python2.7/dist-packages/pkg_resources/__init__.py", line 1069, in obtain
        return installer(requirement)
      File "/usr/lib/python2.7/dist-packages/setuptools/dist.py", line 580, in fetch_build_egg
        return cmd.easy_install(req)
      File "/usr/lib/python2.7/dist-packages/setuptools/command/easy_install.py", line 698, in easy_install
        return self.install_item(spec, dist.location, tmpdir, deps)
      File "/usr/lib/python2.7/dist-packages/setuptools/command/easy_install.py", line 724, in install_item
        dists = self.install_eggs(spec, download, tmpdir)
      File "/usr/lib/python2.7/dist-packages/setuptools/command/easy_install.py", line 909, in install_eggs
        return self.build_and_install(setup_script, setup_base)
      File "/usr/lib/python2.7/dist-packages/setuptools/command/easy_install.py", line 1177, in build_and_install
        self.run_setup(setup_script, setup_base, args)
      File "/usr/lib/python2.7/dist-packages/setuptools/command/easy_install.py", line 1163, in run_setup
        run_setup(setup_script, args)
      File "/usr/lib/python2.7/dist-packages/setuptools/sandbox.py", line 253, in run_setup
        raise
      File "/usr/lib/python2.7/contextlib.py", line 35, in __exit__
        self.gen.throw(type, value, traceback)
      File "/usr/lib/python2.7/dist-packages/setuptools/sandbox.py", line 195, in setup_context
        yield
      File "/usr/lib/python2.7/contextlib.py", line 35, in __exit__
        self.gen.throw(type, value, traceback)
      File "/usr/lib/python2.7/dist-packages/setuptools/sandbox.py", line 166, in save_modules
        saved_exc.resume()
      File "/usr/lib/python2.7/dist-packages/setuptools/sandbox.py", line 141, in resume
        six.reraise(type, exc, self._tb)
      File "/usr/lib/python2.7/dist-packages/setuptools/sandbox.py", line 154, in save_modules
        yield saved
      File "/usr/lib/python2.7/dist-packages/setuptools/sandbox.py", line 195, in setup_context
        yield
      File "/usr/lib/python2.7/dist-packages/setuptools/sandbox.py", line 250, in run_setup
        _execfile(setup_script, ns)
      File "/usr/lib/python2.7/dist-packages/setuptools/sandbox.py", line 44, in _execfile
        code = compile(script, filename, 'exec')
      File "/tmp/easy_install-W_oojy/setuptools_scm-7.0.5/setup.py", line 20
        def scm_version() -> str:
                          ^
    SyntaxError: invalid syntax

    ----------------------------------------
Command "python setup.py egg_info" failed with error code 1 in /tmp/pip-install-dUM5YF/fusesoc/
You are using pip version 19.0.2, however version 20.3.4 is available.
You should consider upgrading via the 'pip install --upgrade pip' command.
gojimmypi:~
$
```

Here are some version details:

```
gojimmypi:~
$ lsb_release -a
No LSB modules are available.
Distributor ID: Ubuntu
Description:    Ubuntu 18.04.5 LTS
Release:        18.04
Codename:       bionic
gojimmypi:~
$ python --version
Python 2.7.17
gojimmypi:~
$ python3 --version
Python 3.6.9
gojimmypi:~
$
```

KinzaQamar, 2022-07-23:
Hi,
Try to follow the steps here:
https://fusesoc.readthedocs.io/en/stable/user/installation.html
Hope it resolves the issue

gojimmypi, 2022-07-23:
Hi @KinzaQamar and thanks for your suggestions.

I tried the `pip3` on the `readthedocs` link instead of the README file, but it appears python had already worked that out (I've since been  trying to get this working).

```
C:\workspace\myfusesoc>pip3 install --upgrade --user fusesoc
Requirement already up-to-date: fusesoc in c:\users\gojimmypi\appdata\local\programs\python\python38-32\lib\site-packages (1.12.0)
Requirement already satisfied, skipping upgrade: pyparsing in c:\users\gojimmypi\appdata\local\programs\python\python38-32\lib\site-packages (from fusesoc) (3.0.9)
Requirement already satisfied, skipping upgrade: pyyaml in c:\users\gojimmypi\appdata\local\programs\python\python38-32\lib\site-packages (from fusesoc) (6.0)
Requirement already satisfied, skipping upgrade: simplesat>=0.8.0 in c:\users\gojimmypi\appdata\local\programs\python\python38-32\lib\site-packages (from fusesoc) (0.8.2)
Requirement already satisfied, skipping upgrade: edalize>=0.2.3 in c:\users\gojimmypi\appdata\local\programs\python\python38-32\lib\site-packages (from fusesoc) (0.4.0)
Requirement already satisfied, skipping upgrade: ipyxact>=0.2.3 in c:\users\gojimmypi\appdata\local\programs\python\python38-32\lib\site-packages (from fusesoc) (0.3.2)
Requirement already satisfied, skipping upgrade: attrs>=17.4.0 in c:\users\gojimmypi\appdata\local\programs\python\python38-32\lib\site-packages (from simplesat>=0.8.0->fusesoc) (21.4.0)
Requirement already satisfied, skipping upgrade: okonomiyaki>=0.16.6 in c:\users\gojimmypi\appdata\local\programs\python\python38-32\lib\site-packages (from simplesat>=0.8.0->fusesoc) (1.3.2)
Requirement already satisfied, skipping upgrade: six>=1.10.0 in c:\users\gojimmypi\appdata\local\programs\python\python38-32\lib\site-packages (from simplesat>=0.8.0->fusesoc) (1.16.0)
Requirement already satisfied, skipping upgrade: Jinja2>=3 in c:\users\gojimmypi\appdata\local\programs\python\python38-32\lib\site-packages (from edalize>=0.2.3->fusesoc) (3.1.2)
Requirement already satisfied, skipping upgrade: distro; python_version >= "3.8" in c:\users\gojimmypi\appdata\local\programs\python\python38-32\lib\site-packages (from okonomiyaki>=0.16.6->simplesat>=0.8.0->fusesoc) (1.7.0)
Requirement already satisfied, skipping upgrade: zipfile2>=0.0.12 in c:\users\gojimmypi\appdata\local\programs\python\python38-32\lib\site-packages (from okonomiyaki>=0.16.6->simplesat>=0.8.0->fusesoc) (0.0.12)
Requirement already satisfied, skipping upgrade: jsonschema>=2.5.1 in c:\users\gojimmypi\appdata\local\programs\python\python38-32\lib\site-packages (from okonomiyaki>=0.16.6->simplesat>=0.8.0->fusesoc) (4.7.2)
Requirement already satisfied, skipping upgrade: MarkupSafe>=2.0 in c:\users\gojimmypi\appdata\local\programs\python\python38-32\lib\site-packages (from Jinja2>=3->edalize>=0.2.3->fusesoc) (2.1.1)
Requirement already satisfied, skipping upgrade: importlib-resources>=1.4.0; python_version < "3.9" in c:\users\gojimmypi\appdata\local\programs\python\python38-32\lib\site-packages (from jsonschema>=2.5.1->okonomiyaki>=0.16.6->simplesat>=0.8.0->fusesoc) (5.9.0)
Requirement already satisfied, skipping upgrade: pyrsistent!=0.17.0,!=0.17.1,!=0.17.2,>=0.14.0 in c:\users\gojimmypi\appdata\local\programs\python\python38-32\lib\site-packages (from jsonschema>=2.5.1->okonomiyaki>=0.16.6->simplesat>=0.8.0->fusesoc) (0.18.1)
Requirement already satisfied, skipping upgrade: zipp>=3.1.0; python_version < "3.10" in c:\users\gojimmypi\appdata\local\programs\python\python38-32\lib\site-packages (from importlib-resources>=1.4.0; python_version < "3.9"->jsonschema>=2.5.1->okonomiyaki>=0.16.6->simplesat>=0.8.0->fusesoc) (3.8.1)
WARNING: You are using pip version 19.2.3, however version 22.1.2 is available.
You should consider upgrading via the 'python -m pip install --upgrade pip' command.
```

It still might be a good idea to detect python versions more gracefully with `pip`  vs `pip3` ? Perhaps just update the README and/or refer to the `readthedocs` link.

The `upgrade` gave essentially the same output as above:  `pip3 install --upgrade fusesoc`

The Windows instructions I assume are very similar, but still listed at a TODO on the `readthedocs` link:

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

gojimmypi, 2022-07-23:
oops, I confused this WSL issue with my Windows issue.

Here's the result in WSL, using `pip3` resolves, but there's a new error:

```
$ pip3 install --upgrade --user fusesoc
Collecting fusesoc
  Cache entry deserialization failed, entry ignored
  Downloading https://files.pythonhosted.org/packages/69/65/e5902fea9bac81e56e4f5d81e4a2ba497244a160f3ffa7df59e7e1d3f030/fusesoc-1.12.0-py3-none-any.whl (63kB)
    100% |████████████████████████████████| 71kB 1.4MB/s
Collecting edalize>=0.2.3 (from fusesoc)
  Downloading https://files.pythonhosted.org/packages/ef/3a/ebaf6e01a797f0ac4896ec4b688b8b39ad22d7919b0d1470c60e591408ad/edalize-0.4.0.tar.gz (337kB)
    100% |████████████████████████████████| 337kB 1.8MB/s
Collecting ipyxact>=0.2.3 (from fusesoc)
  Downloading https://files.pythonhosted.org/packages/e6/4b/3e7485acab5b762f8b417db2fc890c12853a52bef4b278a33ef6919b4808/ipyxact-0.3.2.tar.gz (201kB)
    100% |████████████████████████████████| 204kB 2.5MB/s
Collecting simplesat>=0.8.0 (from fusesoc)
  Downloading https://files.pythonhosted.org/packages/1f/79/aca2b68a5fb5f2a3183bf2ac0f09fb05dc6b4ce859dc1aa52670c44866a8/simplesat-0.8.2-py2.py3-none-any.whl (246kB)
    100% |████████████████████████████████| 256kB 1.5MB/s
Collecting pyyaml (from fusesoc)
  Downloading https://files.pythonhosted.org/packages/b3/85/79b9e5b4e8d3c0ac657f4e8617713cca8408f6cdc65d2ee6554217cedff1/PyYAML-6.0-cp36-cp36m-manylinux_2_5_x86_64.manylinux1_x86_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 (603kB)
    100% |████████████████████████████████| 604kB 1.6MB/s
Collecting pyparsing (from fusesoc)
  Cache entry deserialization failed, entry ignored
  Downloading https://files.pythonhosted.org/packages/6c/10/a7d0fa5baea8fe7b50f448ab742f26f52b80bfca85ac2be9d35cdd9a3246/pyparsing-3.0.9-py3-none-any.whl (98kB)
    100% |████████████████████████████████| 102kB 4.1MB/s
Collecting Jinja2>=3 (from edalize>=0.2.3->fusesoc)
  Cache entry deserialization failed, entry ignored
  Downloading https://files.pythonhosted.org/packages/20/9a/e5d9ec41927401e41aea8af6d16e78b5e612bca4699d417f646a9610a076/Jinja2-3.0.3-py3-none-any.whl (133kB)
    100% |████████████████████████████████| 143kB 3.9MB/s
Collecting six>=1.10.0 (from simplesat>=0.8.0->fusesoc)
  Cache entry deserialization failed, entry ignored
  Using cached https://files.pythonhosted.org/packages/d9/5a/e7c31adbe875f2abbb91bd84cf2dc52d792b5a01506781dbcf25c91daf11/six-1.16.0-py2.py3-none-any.whl
Collecting okonomiyaki>=0.16.6 (from simplesat>=0.8.0->fusesoc)
  Downloading https://files.pythonhosted.org/packages/81/df/1ec79aeb85dd3e6551bba3d7a2bfa8591e1bafc69e7d405fdf6132f65bf1/okonomiyaki-1.3.2-py3-none-any.whl (2.8MB)
    100% |████████████████████████████████| 2.8MB 434kB/s
Collecting attrs>=17.4.0 (from simplesat>=0.8.0->fusesoc)
  Cache entry deserialization failed, entry ignored
  Downloading https://files.pythonhosted.org/packages/be/be/7abce643bfdf8ca01c48afa2ddf8308c2308b0c3b239a44e57d020afa0ef/attrs-21.4.0-py2.py3-none-any.whl (60kB)
    100% |████████████████████████████████| 61kB 2.5MB/s
Collecting MarkupSafe>=2.0 (from Jinja2>=3->edalize>=0.2.3->fusesoc)
  Cache entry deserialization failed, entry ignored
  Using cached https://files.pythonhosted.org/packages/fc/d6/57f9a97e56447a1e340f8574836d3b636e2c14de304943836bd645fa9c7e/MarkupSafe-2.0.1-cp36-cp36m-manylinux1_x86_64.whl
Collecting zipfile2>=0.0.12 (from okonomiyaki>=0.16.6->simplesat>=0.8.0->fusesoc)
  Downloading https://files.pythonhosted.org/packages/60/ad/d6bc08f235b66c11bbb76df41b973ce93544a907cc0e23c726ea374eee79/zipfile2-0.0.12-py2.py3-none-any.whl (44kB)
    100% |████████████████████████████████| 51kB 1.5MB/s
Collecting jsonschema>=2.5.1 (from okonomiyaki>=0.16.6->simplesat>=0.8.0->fusesoc)
  Downloading https://files.pythonhosted.org/packages/e0/d9/05587ac378b9fd2c352c6f024f13240168365bd753a7e8007522b7025267/jsonschema-4.0.0-py3-none-any.whl (69kB)
    100% |████████████████████████████████| 71kB 2.6MB/s
Collecting importlib-metadata; python_version < "3.8" (from jsonschema>=2.5.1->okonomiyaki>=0.16.6->simplesat>=0.8.0->fusesoc)
  Cache entry deserialization failed, entry ignored
  Downloading https://files.pythonhosted.org/packages/a0/a1/b153a0a4caf7a7e3f15c2cd56c7702e2cf3d89b1b359d1f1c5e59d68f4ce/importlib_metadata-4.8.3-py3-none-any.whl
Collecting pyrsistent!=0.17.0,!=0.17.1,!=0.17.2,>=0.14.0 (from jsonschema>=2.5.1->okonomiyaki>=0.16.6->simplesat>=0.8.0->fusesoc)
  Downloading https://files.pythonhosted.org/packages/6c/19/1af501f6f388a40ede6d0185ba481bdb18ffc99deab0dd0d092b173bc0f4/pyrsistent-0.18.0-cp36-cp36m-manylinux1_x86_64.whl (117kB)
    100% |████████████████████████████████| 122kB 2.0MB/s
Collecting typing-extensions>=3.6.4; python_version < "3.8" (from importlib-metadata; python_version < "3.8"->jsonschema>=2.5.1->okonomiyaki>=0.16.6->simplesat>=0.8.0->fusesoc)
  Cache entry deserialization failed, entry ignored
  Downloading https://files.pythonhosted.org/packages/45/6b/44f7f8f1e110027cf88956b59f2fad776cca7e1704396d043f89effd3a0e/typing_extensions-4.1.1-py3-none-any.whl
Collecting zipp>=0.5 (from importlib-metadata; python_version < "3.8"->jsonschema>=2.5.1->okonomiyaki>=0.16.6->simplesat>=0.8.0->fusesoc)
  Cache entry deserialization failed, entry ignored
  Downloading https://files.pythonhosted.org/packages/bd/df/d4a4974a3e3957fd1c1fa3082366d7fff6e428ddb55f074bf64876f8e8ad/zipp-3.6.0-py3-none-any.whl
Building wheels for collected packages: edalize, ipyxact
  Running setup.py bdist_wheel for edalize ... done
  Stored in directory: /home/gojimmypi/.cache/pip/wheels/eb/13/f0/616f11563663b3c48fd61abfc03acd9b6c92a1880076c41d00
  Running setup.py bdist_wheel for ipyxact ... done
  Stored in directory: /home/gojimmypi/.cache/pip/wheels/28/3d/e2/9d87f6119af6ca91e2aad9f8268e6459a9d357f771a22d81a4
Successfully built edalize ipyxact
Installing collected packages: MarkupSafe, Jinja2, edalize, pyyaml, ipyxact, six, zipfile2, typing-extensions, zipp, importlib-metadata, pyrsistent, attrs, jsonschema, okonomiyaki, simplesat, pyparsing, fusesoc
Successfully installed Jinja2-3.0.3 MarkupSafe-2.0.1 attrs-21.4.0 edalize-0.4.0 fusesoc-1.12.0 importlib-metadata-4.8.3 ipyxact-0.3.2 jsonschema-4.0.0 okonomiyaki-1.3.2 pyparsing-3.0.9 pyrsistent-0.18.0 pyyaml-6.0 simplesat-0.8.2 six-1.16.0 typing-extensions-4.1.1 zipfile2-0.0.12 zipp-3.6.0
gojimmypi:~/workspace/mywslfusesoc
$ fusesoc run --target=tinyfpga_bx servant
ERROR: 'servant' or any of its dependencies requires 'servant', but this core was not found
gojimmypi:~/workspace/mywslfusesoc
$ fusesoc run --target=verilator_tb servant --uart_baudrate=57600 --firmware=$SERV/sw/zephyr_hello.hex
ERROR: 'servant' or any of its dependencies requires 'servant', but this core was not found
gojimmypi:~/workspace/mywslfusesoc
$

```

it appears the libraries were not installed, so I added them:

```
gojimmypi:~/workspace/mywslfusesoc
$ fusesoc library list
Name : Location : Sync type : Sync URI : Auto sync
gojimmypi:~/workspace/mywslfusesoc
$ fusesoc library add fusesoc-cores https://github.com/fusesoc/fusesoc-cores
INFO: Cloning library into fusesoc_libraries/fusesoc-cores
Cloning into 'fusesoc_libraries/fusesoc-cores'...
remote: Enumerating objects: 678, done.
remote: Counting objects: 100% (101/101), done.
remote: Compressing objects: 100% (26/26), done.
remote: Total 678 (delta 94), reused 78 (delta 75), pack-reused 577
Receiving objects: 100% (678/678), 141.02 KiB | 8.29 MiB/s, done.
Resolving deltas: 100% (265/265), done.
```

but now getting this error:

```
gojimmypi:~/workspace/mywslfusesoc
$ fusesoc run --target=tinyfpga_bx servant
INFO: Preparing fusesoc:utils:generators:0.1.7
INFO: Downloading fusesoc/fusesoc-generators from github
INFO: Preparing ::serv:1.0.2
INFO: Downloading olofk/serv from github
INFO: Preparing ::servant:1.0.2-r1
INFO: Downloading olofk/serv from github
INFO: Generating ::servant-tinyfpga_bx_pll:1.0.2

F_PLLIN:    16.000 MHz (given)
F_PLLOUT:   32.000 MHz (requested)
F_PLLOUT:   32.000 MHz (achieved)

[ .. snip .. ]

25.3.5. Executing AST frontend in derive mode using pre-parsed AST for module `\servant_timer'.
Parameter \WIDTH = 32
Parameter \RESET_STRATEGY = 1296649801
Generating RTLIL representation for module `$paramod\servant_timer\WIDTH=32\RESET_STRATEGY=1296649801'.
Note: Assuming pure combinatorial block at ../src/servant_1.0.2-r1/servant/servant_timer.v:21.4-24.7 in
compliance with IEC 62142(E):2005 / IEEE Std. 1364.1(E):2002. Recommending
use of @* instead of @(...) for better match of synthesis and simulation.
Parameter \RESET_PC = 0
Parameter \WITH_CSR = 1

25.3.6. Executing AST frontend in derive mode using pre-parsed AST for module `\serv_rf_top'.
Parameter \RESET_PC = 0
Parameter \WITH_CSR = 1
Generating RTLIL representation for module `$paramod\serv_rf_top\RESET_PC=0\WITH_CSR=1'.
../src/servant_1.0.2-r1/servant/servant_timer.v:0: ERROR: Can't find object for defparam `RESET_STRATEGY`!
Makefile:8: recipe for target 'servant_1.0.2-r1.json' failed
make: *** [servant_1.0.2-r1.json] Error 1
ERROR: Failed to build ::servant:1.0.2-r1 : '['make']' exited with an error: 2
gojimmypi:~/workspace/mywslfusesoc
$
```

gojimmypi, 2022-07-23:
update: SUCCESS~

I compared `fusesoc library list` on WSL to my Windows/DOS version.

Ran this: `fusesoc library add servant https://github.com/olofk/serv`

```
$ fusesoc library list
Name          : Location                        : Sync type : Sync URI                                 : Auto sync
fusesoc-cores : fusesoc_libraries/fusesoc-cores : git       : https://github.com/fusesoc/fusesoc-cores : y
gojimmypi:~/workspace/mywslfusesoc
$ fusesoc library add servant https://github.com/olofk/serv
INFO: Cloning library into fusesoc_libraries/servant
Cloning into 'fusesoc_libraries/servant'...
remote: Enumerating objects: 2471, done.
remote: Counting objects: 100% (583/583), done.
remote: Compressing objects: 100% (187/187), done.
remote: Total 2471 (delta 458), reused 417 (delta 393), pack-reused 1888
Receiving objects: 100% (2471/2471), 5.27 MiB | 8.05 MiB/s, done.
Resolving deltas: 100% (1585/1585), done.
```

and... TADA!

```
gojimmypi:~/workspace/mywslfusesoc
$ fusesoc run --target=tinyfpga_bx servant
INFO: Preparing fusesoc:utils:generators:0.1.7
INFO: Preparing ::serv:1.1.0
INFO: Preparing ::servant:1.1.0
INFO: Generating ::servant-tinyfpga_bx_pll:1.1.0

F_PLLIN:    16.000 MHz (given)
F_PLLOUT:   32.000 MHz (requested)
F_PLLOUT:   32.000 MHz (achieved)

FEEDBACK: SIMPLE
F_PFD:   16.000 MHz
F_VCO: 1024.000 MHz

[ .. snip .. ]

Info: Max delay posedge wb_clk_$glb_clk -> <async>: 4.05 ns

Info: Slack histogram:
Info:  legend: * represents 3 endpoint(s)
Info:          + represents [1,3) endpoint(s)
Info: [ 15256,  15948) |+
Info: [ 15948,  16640) |+
Info: [ 16640,  17332) |
Info: [ 17332,  18024) |************+
Info: [ 18024,  18716) |*************+
Info: [ 18716,  19408) |**+
Info: [ 19408,  20100) |**************+
Info: [ 20100,  20792) |*************+
Info: [ 20792,  21484) |*****+
Info: [ 21484,  22176) |******+
Info: [ 22176,  22868) |************+
Info: [ 22868,  23560) |******************************+
Info: [ 23560,  24252) |*******************************************************+
Info: [ 24252,  24944) |*********************************+
Info: [ 24944,  25636) |**************************+
Info: [ 25636,  26328) |*****************************************+
Info: [ 26328,  27020) |*****+
Info: [ 27020,  27712) |***********+
Info: [ 27712,  28404) |********************+
Info: [ 28404,  29096) |************************************************************
icepack servant_1.1.0.asc servant_1.1.0.bin
INFO: Running
gojimmypi:~/workspace/mywslfuseso
```

success!

KinzaQamar, 2022-07-23:
Awesome !

olofk, 2022-07-24:
Great to see you got it working. Thanks for the detailed reports of your struggles. Thought I had seen the last Python2 issue, but it seems python2 just refuses to die. You're probably right that it's better to explicitly mention `pip3` over `pip` for systems that still use python2 as the default version.

The other error (`ERROR: Can't find object for defparam `RESET_STRATEGY`!`) has been fixed by adding a newer version of SERV (with the error fixed) to the `fusesoc-cores` library

Thread 85 (2022-07-23):

fusesoc library add does not detect duplicates

gojimmypi, 2022-07-23:
My `fusesoc library list` seemed somewhat short. Ok, I didn't know how long it should be, I suppose I was expecting to see a list of boards.

Running `fusesoc library add` as noted in the instructions just added a duplicate `fusesoc-cores` for me. (see below)

Perhaps it would be good if it stated `[name]` was already installed?

```
C:\workspace\myfusesoc>fusesoc library list
Name          : Location                        : Sync type : Sync URI                                 : Auto sync
fusesoc_cores : fusesoc_libraries\fusesoc_cores : git       : https://github.com/fusesoc/fusesoc-cores : y
serv          : fusesoc_libraries\serv          : git       : https://github.com/olofk/serv            : y

C:\workspace\myfusesoc>fusesoc library add fusesoc-cores https://github.com/fusesoc/fusesoc-cores
←[1;37mINFO: Cloning library into fusesoc_libraries\fusesoc-cores←[0m
Cloning into 'fusesoc_libraries\fusesoc-cores'...
remote: Enumerating objects: 678, done.
remote: Counting objects: 100% (101/101), done.
remote: Compressing objects: 100% (26/26), done.
Receiving objects:  89% (604
Receiving objects: 100% (678/678), 141.02 KiB | 2.61 MiB/s, done.
Resolving deltas: 100% (265/265), done.

C:\workspace\myfusesoc>fusesoc library list
Name          : Location                        : Sync type : Sync URI                                 : Auto sync
fusesoc_cores : fusesoc_libraries\fusesoc_cores : git       : https://github.com/fusesoc/fusesoc-cores : y
serv          : fusesoc_libraries\serv          : git       : https://github.com/olofk/serv            : y
fusesoc-cores : fusesoc_libraries\fusesoc-cores : git       : https://github.com/fusesoc/fusesoc-cores : y
```

olofk, 2022-07-24:
Definitely. It should not allow two libraries with the saem sync URI. There are other places where the library management is a bit rough around the edges. As you have probably seen by now, there is for example no way to unregister a library other than edit fusesoc.conf in the workspace

Thread 86 (2022-07-23):

fusesoc problems with python on Windows - python3 vs python

gojimmypi, 2022-07-23:
similar to https://github.com/olofk/serv/issues/83 in WSL, the Windows version of `fusesoc` seems to not properly detect which version of python to use.

Here in Windows, `python` is Python version 3.6 and `python3` is not defined, causing a `fusesoc` error:

```
C:\workspace\myfusesoc>fusesoc run --target=tinyfpga_bx servant
←[1;37mINFO: Preparing fusesoc:utils:generators:0.1.7←[0m
←[1;37mINFO: Downloading fusesoc/fusesoc-generators from github←[0m
←[1;37mINFO: Preparing ::serv:1.1.0←[0m
←[1;37mINFO: Preparing ::servant:1.1.0←[0m
←[1;37mINFO: Generating ::servant-tinyfpga_bx_pll:1.1.0←[0m
Python was not found; run without arguments to install from the Microsoft Store, or disable this shortcut from Settings > Manage App Execution Aliases.
←[1;31mERROR: Setup failed : "python3 C:\Users\gojimmypi\.cache\fusesoc\fusesoc_utils_generators_0.1.7\icepll.py C:\Users\gojimmypi\.cache\fusesoc\generated\servant-tinyfpga_bx_pll_1.1.0\tinyfpga_bx_pll_input.yml" exited with an error code. See stderr for details.←[0m

C:\workspace\myfusesoc>python3 --version
Python was not found; run without arguments to install from the Microsoft Store, or disable this shortcut from Settings > Manage App Execution Aliases.

C:\workspace\myfusesoc>python --version
Python 3.8.1
```

KinzaQamar, 2022-07-23:
Hi,
Check which version of fusesoc you are on through this command ```fusesoc --version``` .
Version 1.10 of fusesoc supports python2.7. I am not sure but my best guess is the installed version of fusesoc is not compatible with the installed version of python.

Try this command ``sudo pip3 install --upgrade fusesoc``. As you already have fusesoc, this command will upgrade the older version to a newer one.
If the above command still gives an error, try to install the python3 dependencies then run the above command.

Hope it will do something.

gojimmypi, 2022-07-23:
Hi @KinzaQamar - I appreciate your assistance.

I was able to eventually get `fusesoc` installed, per `pip` vs `pip3 noted in https://github.com/olofk/serv/issues/83

The `fusesoc`` version on Windows reports:

```
C:\workspace\myfusesoc>fusesoc --version
1.12.0
```

but I still see this error:

```
C:\workspace\myfusesoc>fusesoc run --target=tinyfpga_bx servant
←[1;37mINFO: Preparing fusesoc:utils:generators:0.1.7←[0m
←[1;37mINFO: Preparing ::serv:1.1.0←[0m
←[1;37mINFO: Preparing ::servant:1.1.0←[0m
←[1;37mINFO: Generating ::servant-tinyfpga_bx_pll:1.1.0←[0m
Python was not found; run without arguments to install from the Microsoft Store, or disable this shortcut from Settings > Manage App Execution Aliases.
←[1;31mERROR: Setup failed : "python3 C:\Users\gojimmypi\.cache\fusesoc\fusesoc_utils_generators_0.1.7\icepll.py C:\Users\gojimmypi\.cache\fusesoc\generated\servant-tinyfpga_bx_pll_1.1.0\tinyfpga_bx_pll_input.yml" exited with an error code. See stderr for details.←[0m

```

KinzaQamar, 2022-07-23:
Hi,
Do you have python3 dependencies installed already?

gojimmypi, 2022-07-24:
Hi @KinzaQamar - which dependencies are you referring to? The `pip3 install fusesoc`? Yes.

Here's the output from various commands. I created a new `C:\workspace\myfusesoc2` Windows directory to start fresh:

```
C:\workspace\myfusesoc2>fusesoc core show servant
CORE INFO
Name:      ::servant:1.1.0
Core root: fusesoc_libraries\serv

Targets:
ac701           : <No description>
alhambra        : Open-hardware iCE40HX4K FPGA board
arty_a7_35t     : <No description>
ax309           : XILINX Spartan-6 XC6SLX9 FPGA Development Board
chameleon96     : Chameleon96 (Arrow 96 CV SoC Board)
cmod_a7_35t     : <No description>
cyc1000         : cyc1000 FPGA board
de0_nano        : <No description>
de10_nano       : Terasic DE10 Nano Kit
deca            : DECA development kit by Arrow / Terasic
default         : <No description>
ebaz4205        : EBAZ4205 'Development' Board
go_board        : <No description>
icebreaker      : <No description>
icestick        : <No description>
icesugar        : iCE40UP5K Development Board by MuseLab
lint            : <No description>
lx9_microboard  : LX9 Microboard
nexys_2_1200    : <No description>
nexys_2_500     : <No description>
nexys_a7        : <No description>
orangecrab_r0.2 : OrangeCrab R0.2
pipistrello     : Saanlima pipistrello
sim             : <No description>
sockit          : SoCKit development kit by Arrow / Terasic
tinyfpga_bx     : <No description>
ulx3s_85        : ULX3S 85k version
upduino2        : <No description>
verilator_tb    : <No description>
zcu106          : Zynq UltraScale+ MPSoC ZCU106 Evaluation Kit

C:\workspace\myfusesoc2>fusesoc library list
Name          : Location                        : Sync type : Sync URI                                 : Auto sync
fusesoc_cores : fusesoc_libraries\fusesoc_cores : git       : https://github.com/fusesoc/fusesoc-cores : y
serv          : fusesoc_libraries\serv          : git       : https://github.com/olofk/serv            : y

C:\workspace\myfusesoc2>fusesoc run --target=tinyfpga_bx servant
←[1;37mINFO: Preparing fusesoc:utils:generators:0.1.7←[0m
←[1;37mINFO: Preparing ::serv:1.1.0←[0m
←[1;37mINFO: Preparing ::servant:1.1.0←[0m
←[1;37mINFO: Generating ::servant-tinyfpga_bx_pll:1.1.0←[0m
Python was not found; run without arguments to install from the Microsoft Store, or disable this shortcut from Settings > Manage App Execution Aliases.
←[1;31mERROR: Setup failed : "python3 C:\Users\gojimmypi\.cache\fusesoc\fusesoc_utils_generators_0.1.7\icepll.py C:\Users\gojimmypi\.cache\fusesoc\generated\servant-tinyfpga_bx_pll_1.1.0\tinyfpga_bx_pll_input.yml" exited with an error code. See stderr for details.←[0m

C:\workspace\myfusesoc2> fusesoc --version
1.12.0

C:\workspace\myfusesoc2>pip3 install --upgrade fusesoc
Requirement already up-to-date: fusesoc in c:\users\gojimmypi\appdata\local\programs\python\python38-32\lib\site-packages (1.12.0)
Requirement already satisfied, skipping upgrade: simplesat>=0.8.0 in c:\users\gojimmypi\appdata\local\programs\python\python38-32\lib\site-packages (from fusesoc) (0.8.2)
Requirement already satisfied, skipping upgrade: edalize>=0.2.3 in c:\users\gojimmypi\appdata\local\programs\python\python38-32\lib\site-packages (from fusesoc) (0.4.0)
Requirement already satisfied, skipping upgrade: ipyxact>=0.2.3 in c:\users\gojimmypi\appdata\local\programs\python\python38-32\lib\site-packages (from fusesoc) (0.3.2)
Requirement already satisfied, skipping upgrade: pyparsing in c:\users\gojimmypi\appdata\local\programs\python\python38-32\lib\site-packages (from fusesoc) (3.0.9)
Requirement already satisfied, skipping upgrade: pyyaml in c:\users\gojimmypi\appdata\local\programs\python\python38-32\lib\site-packages (from fusesoc) (6.0)
Requirement already satisfied, skipping upgrade: six>=1.10.0 in c:\users\gojimmypi\appdata\local\programs\python\python38-32\lib\site-packages (from simplesat>=0.8.0->fusesoc) (1.16.0)
Requirement already satisfied, skipping upgrade: okonomiyaki>=0.16.6 in c:\users\gojimmypi\appdata\local\programs\python\python38-32\lib\site-packages (from simplesat>=0.8.0->fusesoc) (1.3.2)
Requirement already satisfied, skipping upgrade: attrs>=17.4.0 in c:\users\gojimmypi\appdata\local\programs\python\python38-32\lib\site-packages (from simplesat>=0.8.0->fusesoc) (21.4.0)
Requirement already satisfied, skipping upgrade: Jinja2>=3 in c:\users\gojimmypi\appdata\local\programs\python\python38-32\lib\site-packages (from edalize>=0.2.3->fusesoc) (3.1.2)
Requirement already satisfied, skipping upgrade: distro; python_version >= "3.8" in c:\users\gojimmypi\appdata\local\programs\python\python38-32\lib\site-packages (from okonomiyaki>=0.16.6->simplesat>=0.8.0->fusesoc) (1.7.0)
Requirement already satisfied, skipping upgrade: zipfile2>=0.0.12 in c:\users\gojimmypi\appdata\local\programs\python\python38-32\lib\site-packages (from okonomiyaki>=0.16.6->simplesat>=0.8.0->fusesoc) (0.0.12)
Requirement already satisfied, skipping upgrade: jsonschema>=2.5.1 in c:\users\gojimmypi\appdata\local\programs\python\python38-32\lib\site-packages (from okonomiyaki>=0.16.6->simplesat>=0.8.0->fusesoc) (4.7.2)
Requirement already satisfied, skipping upgrade: MarkupSafe>=2.0 in c:\users\gojimmypi\appdata\local\programs\python\python38-32\lib\site-packages (from Jinja2>=3->edalize>=0.2.3->fusesoc) (2.1.1)
Requirement already satisfied, skipping upgrade: importlib-resources>=1.4.0; python_version < "3.9" in c:\users\gojimmypi\appdata\local\programs\python\python38-32\lib\site-packages (from jsonschema>=2.5.1->okonomiyaki>=0.16.6->simplesat>=0.8.0->fusesoc) (5.9.0)
Requirement already satisfied, skipping upgrade: pyrsistent!=0.17.0,!=0.17.1,!=0.17.2,>=0.14.0 in c:\users\gojimmypi\appdata\local\programs\python\python38-32\lib\site-packages (from jsonschema>=2.5.1->okonomiyaki>=0.16.6->simplesat>=0.8.0->fusesoc) (0.18.1)
Requirement already satisfied, skipping upgrade: zipp>=3.1.0; python_version < "3.10" in c:\users\gojimmypi\appdata\local\programs\python\python38-32\lib\site-packages (from importlib-resources>=1.4.0; python_version < "3.9"->jsonschema>=2.5.1->okonomiyaki>=0.16.6->simplesat>=0.8.0->fusesoc) (3.8.1)
WARNING: You are using pip version 19.2.3, however version 22.1.2 is available.
You should consider upgrading via the 'python -m pip install --upgrade pip' command.
```

Although it might be nice to get this working on Windows, this issue is not nearly as important since I have `fusesoc` working on WSL as noted in https://github.com/olofk/serv/issues/83#issuecomment-1193150975

olofk, 2022-07-24:
Hmm... this one is a bit tricky. I would had assumed that there would be a python3 symlink/alias on every platform. Especially since we have seen other places where things go haywire because python is linked to python2.

For this particular problem, I see a manual workaround for now. Edit `C:\workspace\myfusesoc2\fusesoc_libraries\fusesoc-cores\fusesoc_utils\generators-0.1.7.core` and change the interpreter on line 50 from `python3` to `python`. Some context: The servant SoC is using a generator (generators are kind of plugins in the FuseSoC world) to create a PLL with desired frequency settings. This generator is implemented in python, and the core description file for the generator (that you are about to edit) explicitly tells FuseSoC to launch this generator with python3.

Thread 87 (2022-08-01):

Dockerfile for SERV environment

sbates130272, 2022-08-01:
Hi

I would like to propose we add a docker folder with a Dockerfile in it that contains a Ubuntu based container with all the packages and other assorted goodies needed to build the SERV CPU and run tests. I would be happy to work on a PR for this based on the contents of the CI workflows already checked in.

Is this something that others would consider useful? I would plan to default to checking out the HEAD of the master branch but allow users to pass tags or SHAs into the build command. I think, in time, we could also extent it to include some of the open-source EDA tools needed to build bitstreams for some of the target FPGA boards etc.

Feedback welcome!

olofk, 2022-08-02:
That does sound like a good idea. My biggest question would be how people expect to use such an image. As I'm not using Docker regularly myself I'm not sure what the expected work flow looks like

sbates130272, 2022-08-03:
@olofk what I typically do is create the Dockerfile and update the README at the top-level to include a reference to it and tell the user that all the necessary software is already installed. Once they spin up the image they can just run it and have all the tools they need ready to be used.

I'll try and put something together for review in the next few days.

Thread 93 (2022-11-14):

Unable to run Compliance Tests

AshvinVaidyanathan, 2022-11-14:
```
ls: cannot access '/home/ashvin/thesis/workspace/riscv-arch-test/riscv-target/serv/device/rv32i_m': No such file or directory

============================ VARIABLE INFO ==================================
ROOTDIR: /home/ashvin/thesis/workspace/riscv-arch-test [origin: file]
WORK: /home/ashvin/thesis/workspace/riscv-arch-test/work [origin: file]
TARGETDIR: /home/ashvin/thesis/workspace/riscv-arch-test/riscv-target [origin: command line]
RISCV_TARGET: serv [origin: command line]
XLEN: 32 [origin: file]
RISCV_DEVICE: I [origin: command line]
=============================================================================

make -j1 \
	RISCV_TARGET=serv \
	RISCV_DEVICE=I \
	run -C /home/ashvin/thesis/workspace/riscv-arch-test/riscv-test-suite/rv32i_m/I
make[1]: Entering directory '/home/ashvin/thesis/workspace/riscv-arch-test/riscv-test-suite/rv32i_m/I'
../../Makefile.include:25: *** Cannot find '/home/ashvin/thesis/workspace/riscv-arch-test/riscv-target/serv/device/rv32i_m/I/Makefile.include`. Check that RISCV_TARGET and RISCV_DEVICE are set correctly..  Stop.
make[1]: Leaving directory '/home/ashvin/thesis/workspace/riscv-arch-test/riscv-test-suite/rv32i_m/I'
make: *** [Makefile:84: simulate] Error 2
```
As far as I understand I am supposed to point the test to the files built by fusesoc, but there is no such directory once the build is finished. Can someone point me out to where I am going wrong?

KinzaQamar, 2022-11-14:
Hi,

Have you set your WORKSPACE and SERV paths?

AshvinVaidyanathan, 2022-11-15:
Thanks a lot. That worked. Although the first test (ADD) failed. Is this expected?

KinzaQamar, 2022-11-15:
Try to remove work directory inside riscv-arch-test directory before every run.

Closed 2022-11-15.

Thread 96 (2023-03-21):

SERV to design a Many-Core ASAP7 ASIC

manili, 2023-03-21:
Hi all,
What are the minimum requirements of a SERV core to design a many-core ASIC using ASAP7 predictive PDK? I'm thinking about something like SMP architecture and I'm going to use [OpenSoC Fabric](http://www.opensocfabric.org/home.php) as the fabric. I will use ~10mm^2 of die area so I can generate a comparable result with Google's MPWs and SKY130 PDK.

olofk, 2023-03-21:
@gatecat did a synthesis test of SERV for ASAP7 about two years ago (see this video around 3:00 https://award-winning.me/serv-for-a-fistful-of-gates/) which indicated it was around 94um2. Note that this is excluding the register file, so you need 128B SRAM for the RF. The good news however is that if you use the Subservient SoC (https://github.com/olofk/subservient/) you only need one single-port SRAM for RF, code and data memories.

manili, 2023-03-22:
@olofk
Although, `Subservient SoC` could be a very good candidate for the scheduler (manager), there's still an issue with it to be used as the processor for Many-Core or Symmetric-Multiprocessor architecture, it has different functional units (e.g. GPIO, SPI, ...) which are not essential for the role in the architecture.
What I want to do is connecting thousand of SERV cores and x4 8K SRAMs together using mesh topology. Manager/Scheduler (which is going to be Subservient SoC) will read the input from outside, program the x4 SRAMs, initialize SERV cores and start the processing. After process has been done by the cores, it will collect the data and send it to the outside.

olofk, 2023-03-22:
I see. To clarify, I didn't really mean using all of subservient, but perhaps the inner layer (subservient_core) if you want to use a combined memory for RF and code+data. If you are fine having a separate memory for the RF, then you can just use serv_rf_top and connect code/data memory + whatever you want to put on the data bus

olofk, 2023-03-22:
It sounds like a really cool project btw :)

manili, 2023-03-22:
@olofk
I guess I got what you mean, please correct me if I'm wrong:
1. SERV core does not include any sort of RF, $D or $I catch.
2. SERV core technically needs "at least" 2 SRAMs. One as RF (32x32) and one as $D + $I.
3. Subservient is a modification of main SERV core which sees RF + $D + $I as one single unified SRAM.
Is it right? Does Subservient heart different than SERV or you just add some simple MMU stuff to convert RF requests into memory?

Thread 97 (2023-04-23):

%Warning: /sw/zephyr_hello.hex:0: $readmem file not found

DerakhshanAli, 2023-04-23:
hello.
first of all, thanks for sharing the SERV project.
facing problem :
Command : fusesoc run --target=verilator_tb servant --uart_baudrate=57600 --firmware=$SERV/sw/zephyr_hello.hex
Result : Loading RAM from /sw/zephyr_phil.hex
%Warning: /sw/zephyr_phil.hex:0: $readmem file not found

How can i solve this Warning?

i think, it's because this warning ,I **dont** get [***** Booting Zephyr OS zephyr-v1.14.1-4-gc7c2d62513fe *****
Hello World! service]

thanks.

YiminGao0113, 2023-12-16:
Seems like this thread is already closed but I didn't find the answer to this question.. Could someone tell me how I can resolve this Warning, my program got stuck here..
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
Thanks.

olofk, 2023-12-16:
It looks like you haven't set the $SERV environment variable. The --firmware option specify a path to a hex file.

Closed 2023-04-23.

Thread 101 (2023-07-15):

problem w/ building reference ?

BradWalker, 2023-07-15:
I'm following the directions precisely. But, I keep getting  the same error..
```

[bwalker@fedora foo]$ export WORKSPACE=$(pwd)
[bwalker@fedora foo]$ fusesoc library add serv https://github.com/olofk/serv
INFO: Cloning library into fusesoc_libraries/serv
Cloning into 'fusesoc_libraries/serv'...
remote: Enumerating objects: 2672, done.
remote: Counting objects: 100% (709/709), done.
remote: Compressing objects: 100% (221/221), done.
remote: Total 2672 (delta 574), reused 488 (delta 488), pack-reused 1963
Receiving objects: 100% (2672/2672), 12.56 MiB | 10.26 MiB/s, done.
Resolving deltas: 100% (1706/1706), done.
[bwalker@fedora foo]$ ls
build  fusesoc.conf  fusesoc_libraries
[bwalker@fedora foo]$ rm -rf build/
[bwalker@fedora foo]$ fusesoc run --target=lint serv
INFO: Preparing ::serv:1.2.1
INFO: Setting up project
INFO: Building simulation model
INFO: Running
[bwalker@fedora foo]$ fusesoc run --target=verilator_tb servant --uart_baudrate=57600 --firmware=$SERV/sw/zephyr_hello.hex
INFO: Preparing ::serv:1.2.1
INFO: Preparing ::servant:1.2.1
verilator -f servant_1.2.1.vc
make -f Vservant_sim.mk
make[1]: Entering directory '/tmp/foo/build/servant_1.2.1/verilator_tb'
g++  -I.  -MMD -I/usr/share/verilator/include -I/usr/share/verilator/include/vltstd -DVM_COVERAGE=0 -DVM_SC=0 -DVM_TRACE=1 -DVM_TRACE_FST=0 -DVM_TRACE_VCD=1 -faligned-new -fcf-protection=none -Wno-bool-operation -Wno-sign-compare -Wno-uninitialized -Wno-unused-but-set-variable -Wno-unused-parameter -Wno-unused-variable -Wno-shadow      -std=gnu++14 -Os -c -o servant_tb.o src/servant_1.2.1/bench/servant_tb.cpp
g++  -I.  -MMD -I/usr/share/verilator/include -I/usr/share/verilator/include/vltstd -DVM_COVERAGE=0 -DVM_SC=0 -DVM_TRACE=1 -DVM_TRACE_FST=0 -DVM_TRACE_VCD=1 -faligned-new -fcf-protection=none -Wno-bool-operation -Wno-sign-compare -Wno-uninitialized -Wno-unused-but-set-variable -Wno-unused-parameter -Wno-unused-variable -Wno-shadow      -std=gnu++14 -Os -c -o verilated.o /usr/share/verilator/include/verilated.cpp
g++  -I.  -MMD -I/usr/share/verilator/include -I/usr/share/verilator/include/vltstd -DVM_COVERAGE=0 -DVM_SC=0 -DVM_TRACE=1 -DVM_TRACE_FST=0 -DVM_TRACE_VCD=1 -faligned-new -fcf-protection=none -Wno-bool-operation -Wno-sign-compare -Wno-uninitialized -Wno-unused-but-set-variable -Wno-unused-parameter -Wno-unused-variable -Wno-shadow      -std=gnu++14 -Os -c -o verilated_dpi.o /usr/share/verilator/include/verilated_dpi.cpp
g++  -I.  -MMD -I/usr/share/verilator/include -I/usr/share/verilator/include/vltstd -DVM_COVERAGE=0 -DVM_SC=0 -DVM_TRACE=1 -DVM_TRACE_FST=0 -DVM_TRACE_VCD=1 -faligned-new -fcf-protection=none -Wno-bool-operation -Wno-sign-compare -Wno-uninitialized -Wno-unused-but-set-variable -Wno-unused-parameter -Wno-unused-variable -Wno-shadow      -std=gnu++14 -Os -c -o verilated_vcd_c.o /usr/share/verilator/include/verilated_vcd_c.cpp
/usr/bin/perl /usr/share/verilator/bin/verilator_includer -DVL_INCLUDE_OPT=include Vservant_sim.cpp Vservant_sim___024root__DepSet_h03917109__0.cpp Vservant_sim___024root__DepSet_h3f60db9f__0.cpp Vservant_sim_servant__pi1__DepSet_hd3eadecc__0.cpp Vservant_sim_servant__pi1__DepSet_heef88ae2__0.cpp Vservant_sim_servant_ram__pi2__DepSet_h9e6e3df8__0.cpp Vservant_sim__Dpi.cpp Vservant_sim__Trace__0.cpp Vservant_sim___024root__Slow.cpp Vservant_sim___024root__DepSet_h03917109__0__Slow.cpp Vservant_sim___024root__DepSet_h3f60db9f__0__Slow.cpp Vservant_sim_servant_sim__Slow.cpp Vservant_sim_servant_sim__DepSet_h698ba515__0__Slow.cpp Vservant_sim_servant_sim__DepSet_h95578f8b__0__Slow.cpp Vservant_sim_servant__pi1__Slow.cpp Vservant_sim_servant__pi1__DepSet_hd3eadecc__0__Slow.cpp Vservant_sim_servant__pi1__DepSet_heef88ae2__0__Slow.cpp Vservant_sim_servant_ram__pi2__Slow.cpp Vservant_sim_servant_ram__pi2__DepSet_ha27c27ae__0__Slow.cpp Vservant_sim__Syms.cpp Vservant_sim__Trace__0__Slow.cpp > Vservant_sim__ALL.cpp
g++  -I.  -MMD -I/usr/share/verilator/include -I/usr/share/verilator/include/vltstd -DVM_COVERAGE=0 -DVM_SC=0 -DVM_TRACE=1 -DVM_TRACE_FST=0 -DVM_TRACE_VCD=1 -faligned-new -fcf-protection=none -Wno-bool-operation -Wno-sign-compare -Wno-uninitialized -Wno-unused-but-set-variable -Wno-unused-parameter -Wno-unused-variable -Wno-shadow      -std=gnu++14 -Os -c -o Vservant_sim__ALL.o Vservant_sim__ALL.cpp
echo "" > Vservant_sim__ALL.verilator_deplist.tmp
Archive ar -rcs Vservant_sim__ALL.a Vservant_sim__ALL.o
g++    servant_tb.o verilated.o verilated_dpi.o verilated_vcd_c.o Vservant_sim__ALL.a      -o Vservant_sim
rm Vservant_sim__ALL.verilator_deplist.tmp
make[1]: Leaving directory '/tmp/foo/build/servant_1.2.1/verilator_tb'
Loading RAM from /sw/zephyr_hello.hex
%Warning: /sw/zephyr_hello.hex:0: $readmem file not found
^C
Caught ctrl-c

INFO: ****************************
INFO: ****   FuseSoC aborted  ****
INFO: ****************************

[bwalker@fedora foo]$
```

I never seem to get the "Hello World! service" output..

BradWalker, 2023-07-15:
Sorry.. My mistake.. Late at night here.

Closed 2023-07-15.

Thread 102 (2023-08-01):

Just a question building Zephyr demos.

hvegh, 2023-08-01:
Hi Olof,

Thanks for serv!
Yesterday I managed to get the serv core running with the hello world example, running 72Mhz using on a Tang Nano 9K and getting the Hello World @ 259200 baud.

Next step would be change the Hello World application to something useful.

Never used **west** before, any quick commands that will generate a servant risc-v binary from source?

H

hvegh, 2023-08-01:
So far following Zephyr 101 - Creating Your Own Project:
```
west init -m https://github.com/olofk/serv.git
west update
pip install -r  zephyr/scripts/requirements.txt

cd ~/.local
wget https://github.com/zephyrproject-rtos/sdk-ng/releases/download/v0.16.1/zephyr-sdk-0.16.1_linux-x86_64_minimal.tar.xz
tar xvf zephyr-sdk-0.16.1_linux-x86_64_minimal.tar.xz
cd zephyr-sdk-0.16.1
./setup.sh
# select riscv64 toolchain?
# install hosttools

cd ~/prj/zephyrprj/zephyr
west build -p always -b litex_vexriscv samples/hello_world
CMake Error: The source "/home/henk/prj/zephyr-project/zephyr/samples/hello_world/CMakeLists.txt" does not match the source
```
Zephyr install: award winning rabbit hole.

hvegh, 2023-08-01:
retry:

```
cd ~/prj/fusesoc/
west init
west config manifest.path fusesoc_libraries/serv
west update
cd zephyr/samples/hello_world/
west build -b service
```

burb:
```
-- Configuring done (3.5s)
CMake Warning (dev) at /home/henk/prj/fusesoc/zephyr/cmake/linker/ld/target.cmake:33 (add_custom_command):
  Policy CMP0116 is not set: Ninja generators transform DEPFILEs from
  add_custom_command().  Run "cmake --help-policy CMP0116" for policy
  details.  Use the cmake_policy command to set the policy and suppress this
  warning.
Call Stack (most recent call first):
  /home/henk/prj/fusesoc/zephyr/CMakeLists.txt:682 (configure_linker_script)
This warning is for project developers.  Use -Wno-dev to suppress it.
-- Generating done (0.0s)
-- Build files have been written to: /home/henk/prj/fusesoc/zephyr/samples/hello_world/build
-- west build: building application
[1/104] Preparing syscall dependency handling
...
[2/76] Building ASM object ...
fusesoc/fusesoc_libraries/serv/zephyr/soc/riscv/servant/soc_irq.S: Assembler messages:
fusesoc/fusesoc_libraries/serv/zephyr/soc/riscv/servant/soc_irq.S:28: Error: unrecognized opcode `csrrc t1,mip,t0'
fusesoc/fusesoc_libraries/serv/zephyr/soc/riscv/servant/soc_irq.S:47: Error: unrecognized opcode `csrr t0,mcause'
```

hvegh, 2023-08-04:
Disected the gcc options on the commandline:
Question now is how and where to enable these instructions on the Zephyr toolchain...

```
.local/zephyr-sdk-0.16.1/riscv64-zephyr-elf/bin/riscv64-zephyr-elf-gcc
-DBUILD_VERSION=zephyr-v2.4.0
-DKERNEL
-D_FORTIFY_SOURCE=2
-Os -imacros  -ffreestanding -fno-common
-g -mabi=ilp32 -march=rv32ima
-Wall -Wformat
-Wformat-security
-Wno-format-zero-length
-Wno-main -Wno-pointer-sign
-Wpointer-arith
-Wno-address-of-packed-member
-Wno-unused-but-set-variable
-Werror=implicit-int
-fno-asynchronous-unwind-tables
-fno-pie
-fno-pic
-fno-strict-overflow
-fno-reorder-functions -fno-defer-pop -fmacro-prefix-map=/home/henk/prj/fusesoc/zephyr/samples
....
```

olofk, 2023-08-07:
This is an unfortunate change in the toolchains. You will need an older version of zephyr-sdk. It looks like I'm using version 0.11.4. There are probably newer ones that works as well, though. Not to self that this should be added to the instructions as well.

olofk, 2023-08-07:
Ah! I just remembered one more thing. There's a bug in Zephyr that causes some parts of Zephyr to be built with the M extension (mul/div instructions) even if you tell Zephyr that your CPU doesn't support it. This has been fixed in later versions of Zephyr, but for now you need to make the following change manually in Zephyr.

```diff
diff --git a/cmake/compiler/gcc/target_riscv.cmake b/cmake/compiler/gcc/target_riscv.cmake
index 88c7a901f3..ed517538f2 100644
--- a/cmake/compiler/gcc/target_riscv.cmake
+++ b/cmake/compiler/gcc/target_riscv.cmake
@@ -9,7 +9,7 @@ if(CONFIG_64BIT)
     list(APPEND TOOLCHAIN_C_FLAGS -mcmodel=medany)
 else()
     string(CONCAT riscv_mabi  "i" ${riscv_mabi} "32")
-    string(CONCAT riscv_march ${riscv_march} "32ima")
+    string(CONCAT riscv_march ${riscv_march} "32i")
 endif()

 if(CONFIG_FPU)

```

hvegh, 2023-10-27:
Hi Olof,

Sorry for the late response, I finaly managed to get it working.
Since then I moved over to the Litex framework, this has exactly what I need.

Closed 2023-10-27.

Thread 104 (2023-09-01):

Seeking Assistance with SERVANT Integration on Nexys A7 via Eclipse

cmenendezzz, 2023-09-01:
Hello!
I am excited to share that I have successfully implemented SERVANT on my Nexys A7 FPGA board. My primary objective now is to utilize its UART port for communication. I have prior experience implementing other RISC-V processors and debugging them through Eclipse, and I'm eager to replicate the same process with the SERV CPU.

However, during my exploration of the Zephyr documentation, I encountered some challenges. Specifically, I noticed that there are missing includes in the repository, such as:
`#include` `<drivers/timer/system_timer.h>`

I am hopeful that you can help clarify this issue and provide guidance for configuring SERVANT via Eclipse. Your assistance in this endeavor would be greatly appreciated.

Thank you in advance for your support.

olofk, 2023-10-23:
SERV doesn't have a debug interface, so it will not be able to communicate with a debugger at runtime.

Regarding the first include, `system_timer.h` belongs to Zephyr, so if you have set up Zephyr according to the instructions in the SERV README, it should be found automatically.

The other includes you mention are only relevant for when you run a simulation of Servant under Verilator. Those files are created by Verilator when it "verilates" the code (i.e. turning the verilog into a C++ model).

I'm not sure if this helps you, but I'm afraid your expectations of running SERV through eclipse like other CPUs won't work all that well.

Thread 112 (2023-12-03):

Zephyr: k_msleep() doesn't work

m42uko, 2023-12-03:
Hi,

I modified the default `hello_world` sample program to print the Hello World! message in a loop with a delay as follows:

```
diff --git a/samples/hello_world/src/main.c b/samples/hello_world/src/main.c
index 2758d75d3f..a0646c789d 100644
--- a/samples/hello_world/src/main.c
+++ b/samples/hello_world/src/main.c
@@ -5,9 +5,13 @@
  */

 #include <stdio.h>
+#include <zephyr/kernel.h>

 int main(void)
 {
-       printf("Hello World! %s\n", CONFIG_BOARD);
+       while (1) {
+               printf("Hello World! %s\n", CONFIG_BOARD);
+               k_msleep(1);
+       }
        return 0;
 }
```

However, when I run this, I only get a single Hello World printout (this happens for both Zephyr v3.5.0 and v2.4.0):

```

[markus@571aaf79e9b4 workspace]$ fusesoc run --target=verilator_tb servant --uart_baudrate=57600 --firmware=hello.hex
INFO: Preparing ::serv:1.2.1
INFO: Preparing ::servant:1.2.1
make: Nothing to be done for 'all'.
Loading RAM from /home/markus/workspace/hello.hex
*** Booting Zephyr OS build zephyr-v3.5.0 ***
Hello World! service
^C
Caught ctrl-c

INFO: ****************************
INFO: ****   FuseSoC aborted  ****
INFO: ****************************
```

Can you reproduce this / is this a known limitation of servant/service?

Thanks!
Markus

m42uko, 2023-12-03:
Quoting your reply on #111 (to keep the msleep discussion in one thread):

> I haven't had time to look at your work yet, but regarding the msleep issue, there's one thing I would check first. At least in Zephyr 2.4.0, there's a bug that causes mul operations to be emitted in the library code even if the Kconfig settings says not to use hard mul and div. Not sure if this is the problem, but you can e.g. check the compiled zephyr.lst and see if there are any mul operations present.

I first tried on v2.4.0 and ran into the MUL bug. Without any fix (i.e. with "illegal" MULs in the binary), `k_msleep` sleeps for zero time (returns immediately), with your fix from https://github.com/olofk/serv/issues/102#issuecomment-1667263644, it shows the same behavior as vanilla 3.5.0. I haven't checked that there are really no more MULs present. I can look into that in the upcoming days just to make sure.

olofk, 2023-12-03:
I checked now with 2.4.0 and I can reproduce the issue. TBH, I never really understood how this timer API is supposed to work, so there's a fair chance I'm doing something strange but I can't see what it is right away. Will need some debugging. In case you haven't seen already, you can run with `--trace_pc` and `--vcd` to dump the PC and waveform of all signals respectively.

`--trace_pc` generates a `trace.bin` in the work root. You can [this Python script](https://github.com/olofk/serv/files/13539775/trays.py.txt) by passing the Zephyr .elf file as the first argument and trace.bin as the second to generate a listing of how SERV jumps between functions. It's not the best debug tool out there but can be helpful.

m42uko, 2023-12-03:
Ooooh nice, thanks for the tips with debugging this. I'll see whether I can figure something out. (I'll probably get to it only next weekend though.)

m42uko, 2023-12-03:
I think I found the issue. `sys_clock_driver_init` (formerly `z_clock_driver_init') is never called. I added the corresponding macro as part of my v3.5.0 PR.

```
diff --git a/zephyr/drivers/timer/serv_timer.c b/zephyr/drivers/timer/serv_timer.c
index 1691fa1..2039217 100644
--- a/zephyr/drivers/timer/serv_timer.c
+++ b/zephyr/drivers/timer/serv_timer.c
@@ -122,3 +122,6 @@ uint32_t sys_timer_cycle_get_32(void)
 {
        return mtime();
 }
+
+SYS_INIT(sys_clock_driver_init, PRE_KERNEL_2,
+        CONFIG_SYSTEM_CLOCK_INIT_PRIORITY);
```

I haven't verified that the timing checks out yet though.

olofk, 2023-12-03:
Well spotted! I'll do a proper review of #111 as soon as I can

m42uko, 2023-12-03:
Cool, thanks!

m42uko, 2023-12-08:
I think this is a problem in the Verilog timer. Take the following example which resets the Verilog timer close to its overflow value (and adds some debugging):

```diff
diff --git a/servant/servant_timer.v b/servant/servant_timer.v
index 45306e9..656c1cd 100644
--- a/servant/servant_timer.v
+++ b/servant/servant_timer.v
@@ -23,15 +23,21 @@ module servant_timer
       o_wb_dat[HIGH:0] = mtimeslice;
    end

+   always @(posedge o_irq) begin
+      $display("IRQ @0x%x | 0x%x", mtime, mtimecmp);
+   end
+
    always @(posedge i_clk) begin
-      if (i_wb_cyc & i_wb_we)
+      if (i_wb_cyc & i_wb_we) begin
 	mtimecmp <= i_wb_dat[HIGH:0];
+        $display("set irq = 0x%x", i_wb_dat[HIGH:0]);
+      end
       mtime <= mtime + 'd1;
       o_irq <= (mtimeslice - mtimecmp >= 0);
       if (RESET_STRATEGY != "NONE")
 	if (i_rst) begin
-	   mtime <= 0;
-	   mtimecmp <= 0;
+	   mtime <= 4293916296;
+	   mtimecmp <= 4293916296;
 	end
    end
 endmodule
```

If you then run my loopy `hello_world`, you get:

```
make: Nothing to be done for 'all'.
Loading RAM from /home/markus/workspace/hello.hex
IRQ @0xffeff688 | 0xffeff688
set irq = 0xfff16059
set irq = 0xfff16059
IRQ @0xfff1605a | 0xfff16059
*** Booting Zephyr OS build zephyr-v3.5.0 ***
Hello World! service
set irq = 0xfffffc80
set irq = 0xfffffc80
IRQ @0xfffffc81 | 0xfffffc80
set irq = 0x00000900
set irq = 0x00000900
set irq = 0x00009280
set irq = 0x00009280
set irq = 0x00012240
set irq = 0x00012240
set irq = 0x0001abc0
set irq = 0x0001abc0
set irq = 0x00023b80
set irq = 0x00023b80
set irq = 0x0002cb40
set irq = 0x0002cb40
set irq = 0x00035b00
set irq = 0x00035b00
set irq = 0x0003eac0
set irq = 0x0003eac0
set irq = 0x00047a80
set irq = 0x00047a80
set irq = 0x00050a40
set irq = 0x00050a40
set irq = 0x00059a00
set irq = 0x00059a00
set irq = 0x00062380
set irq = 0x00062380
set irq = 0x0006b340
set irq = 0x0006b340
set irq = 0x00074300
set irq = 0x00074300
set irq = 0x0007d2c0
set irq = 0x0007d2c0
set irq = 0x00086280
set irq = 0x00086280
[... many more, they are printed immediately, IRQ is permanently active]
```

PS: I think #109 was supposed to address this, but I do not see how this makes a difference. Example 4-bit timer, max count 15.

* IRQ! We are at count 13. -> We set the next cmp to 4
* Verilog does 13 - 4 = 9, which is greater than zero -> next interrupt fires immediately.

Without having thought it through, wouldn't the following be the proper fix (and even reduce logic):

* `mtime` always increments 1 (no change)
* if `mtime` == `mtimecmp` -> set IRQ (compare equal, set latching IRQ flag)
* if write to bus -> reset IRQ and update mtimecmp (reset latch on bus access)

OR: As a more extreme alternative, change the timer to a self-resetting kind when it reaches cmp (auto retrigger). Advantage: In a tickful kernel, we wouldn't have to do any math in the IRQ (which is important, because there are divisions and multiplications!) Disadvantage: I'll have to check, but we might lose support of tickless kernels, but I'm not sure.

m42uko, 2023-12-08:
Actually, #109 may be correct after all, and the report above might just be related to flawed testing. If I initialize the `last_count` variable properly upon boot (instead of assuming it to be zero), it seems to work fine. Doesn't explain the "stops working after 10 mins" though....

```
@@ -60,7 +60,8 @@ static void timer_isr(void *arg)
int sys_clock_driver_init()
{
	IRQ_CONNECT(RISCV_MACHINE_TIMER_IRQ, 0, timer_isr, NULL, 0);
	set_mtimecmp(mtime() + (uint32_t)CYC_PER_TICK);
	last_count = mtime();
	set_mtimecmp(last_count + (uint32_t)CYC_PER_TICK);
	irq_enable(RISCV_MACHINE_TIMER_IRQ);
	return 0;
}
```

(Added that change to my PR.)

olofk, 2023-12-08:
I can think of a couple of different strategies. One would be to bisect between 2.4 and 3.5 to figure out where it stops working. Or did you say it's not working with 2.4 either? It sucks if we need to wait ten minutes for it to display the problem.

Another way would be to compare the soc support files in serv with the ones upstream and see if there is some issue there.

Replacing the serv_timer with a real risc-v machine timer is probably also a good idea to avoid having to carry our own driver. I started working on that a bit. Will push something later. Also just pushed a branch with some helpful debug registers to make troubleshooting with waveforms slightly less awful https://github.com/olofk/serv/tree/dbg

m42uko, 2023-12-08:
As noted in PR #111 (https://github.com/olofk/serv/pull/111#issuecomment-1847374609), this problems seems to be related to the toolchain emitting invalid MUL instructions (as part of picolibc, even if disabled), breaking the timing calculations. The driver and Verilog appears to be fine.

Closed 2023-12-11.

Thread 113 (2023-12-11):

Interrupts not properly masked in Zephyr

olofk, 2023-12-11:
The Zephyr Dining Philosophers demo crashes when asserts are enabled. Need to investigate if interrupts are handled correctly on the sw and hw sides. Could be an issue that the mpie bit is not readable and writable from software

```
fusesoc run --target=verilator_tb servant --uart_baudrate=55600 --memsize=65536 --firmware zephyr35_phil.hex
INFO: Preparing ::serv:1.2.1
INFO: Preparing ::servant:1.2.1
make: Nothing to be done for 'all'.
Loading RAM from /home/olof/projects/serv/workspace/zephyr35_phil.hex
*** Booting Zephyr OS build zephyr-v3.5.0 ***
Demo Description
----------------
An implementation of a solution to the Dining Philosophers
problem (a classic multi-thread synchronization problem).
This particular implementation demonstrates the usage of multiple
preemptible and cooperative threads of differing priorities, as
well as dynamic mutexes and thread sleeping.

Philosopher 0 [C:-2]   EATING  [  02 ms ]
ASSERTION FAIL [arch_irq_unlocked(key) || _kernel.cpus[0].current->base.thread_state & (((1UL << (0))) | ((1UL << (3))))] @ WEST_TOPDIR/zephyr/kernel/include/kswap.h:02
	Context switching while holding lock!
^C
Caught ctrl-c

INFO: ****************************
INFO: ****   FuseSoC aborted  ****
```

Closed 2024-08-02.

Thread 115 (2024-01-16):

SERV cannot run in fusesoc

YiminGao0113, 2024-01-16:
Hi, could you help me with this issue? When I tried to run fusesoc run --target=lint serv
this error shows up:
INFO: Preparing ::serv:1.2.1
Traceback (most recent call last):
  File "/home/yg9bq/.local/bin/fusesoc", line 8, in <module>
    sys.exit(main())
  File "/home/yg9bq/.local/lib/python3.6/site-packages/fusesoc/main.py", line 672, in main
    fusesoc(args)
  File "/home/yg9bq/.local/lib/python3.6/site-packages/fusesoc/main.py", line 662, in fusesoc
    args.func(fs, args)
  File "/home/yg9bq/.local/lib/python3.6/site-packages/fusesoc/main.py", line 316, in run
    edam_file, backend = fs.get_backend(core, flags, args.backendargs)
  File "/home/yg9bq/.local/lib/python3.6/site-packages/fusesoc/fusesoc.py", line 171, in get_backend
    edam=edam, work_root=work_root, verbose=self.config.verbose
  File "/home/yg9bq/.local/lib/python3.6/site-packages/edalize/edatool.py", line 183, in __init__
    loader=PackageLoader(__package__, "templates"),
  File "/home/yg9bq/.local/lib/python3.6/site-packages/jinja2/loaders.py", line 291, in __init__
    assert loader is not None, "A loader was not found for the package."
AssertionError: A loader was not found for the package.

Thanks in advance!!

anudeepdharavathu, 2024-03-17:
how did you resolve this issue?
can you please help? I have the same issue.

Closed 2024-03-12.

Thread 118 (2024-02-09):

Python package clash

shareefj, 2024-02-09:
I'm trying to run the riscof tests in `verif/` but there seems to be a pip dependency issue between what `fusesoc` requires and the version required for `riscof`.

If I have setup a venv and installed `fusesoc`, running `pip install riscof` results in the following error:

```
ERROR: pip's dependency resolver does not currently take into account all the packages that are installed. This behaviour is the source of the following dependency conflicts.
fusesoc 2.3 requires pyyaml>=6.0, but you have pyyaml 5.2 which is incompatible.
jsonschema2md 1.1.0 requires PyYAML<7.0.0,>=6.0.0, but you have pyyaml 5.2 which is incompatible.
```

However, if I add all dependencies to a single `requierments.txt`, then it seems to install with no issues.  I am very far from a pip expert so thought I'd just report this and see if anyone had any pointers.  Is pip able to resolve dependency clashes if everything is installed at once?

Cheers.

olofk, 2024-02-13:
Yes. I actually have this problem myself. It's the riscv-config package (which is a dependency of riscof) which has a strict dependency on pyyaml 5.2. I'm actually using a modified local version of that package to get around the problem (clone the repo https://github.com/riscv-software-src/riscv-config, change `setup.py` to say `pyyaml>=5.2` instead of `pyyaml==5.2`, and then do a "development install" by running `pip install --user -e .` from the riscv-config repo).

I also had to do a similar hack for riscv_isac to allow for newer versions of pyelftools in the requirements.txt there.

Generally, I do wonder if the whole riscof framework is alive at all tbh. Not that I'm the most active maintainer myself, but I haven't seen any activity for ages in the riscof or riscv-config repos

shareefj, 2024-02-13:
Yeah, having just gone through the pain of setting it up on a core, the documentation is well out of date and there are so many little bugs and issues it feels like it should be scrapped.  I've just emailed Neel who is a repo owner of the arch tests to check.

But anyway, I think you can avoid this issue by adding all your Python dependencies to a single requirements.txt file and update your documentation.  At least that worked for me in my limited testing.

Thread 120 (2024-03-31):

Simulation of the core itself?

YiminGao0113, 2024-03-31:
Hi,

I wanted to ask if it's possible to simulate the SERV core using the provided software but without involving the System-on-Chip. I've been working on integrating SPI/I2C with the core and am looking for ways to verify my work. Could you give me any suggestions on how to proceed with this verification?

Thanks for your help! :)

filmil, 2025-07-07:
Not sure what exactly you mean but I simulated this design in many contexts.

Thread 125 (2024-05-20):

serv irq problem

guillemmmm, 2024-05-20:
I have my serv cpu running and when a new irq comes (that I suppose that have to be enough long to be in an instruction cycle) my program goes to the MTVEC adress. But the current adress is not stored in the MEPC.
So when the interrupt handle finishes, it goes to the main function forgetting that we were in another function, thus overflowing the system stack, (since the SP is not reset).

Closed 2024-05-21.

Thread 131 (2024-08-02):

`wfi` instructions unsupported / broken

m42uko, 2024-08-02:
Zephyr 3.6.0 introduces the use of `wfi` when waiting for interrupts (5fb6e267f629dedb8382da6bcad8018b1bb8930a). Executing this instructions breaks things for us.

# How to reproduce?
Run the following example program (based on `hello_world`) on Zepher >= 3.6.0:
```
#include <stdio.h>
#include <zephyr/kernel.h>

int main(void)
{
	int i=0;
	while (1) {
		printf("Hello World! %s %d\n", CONFIG_BOARD_TARGET, i++);
		k_msleep(1000);
	}
	return 0;
}
```

# Observed behavior
_Hello World_ is printed once, then the application locks up. Not even the interrupt handler in the timer driver is ever called again.

# Expected behavior
_Hello Word_ is printed every 1 second.

olofk, 2024-08-02:
Ok, that's not good. It's a bit surprising that they didn't make WFI support optional in Zephyr. Either way, I think that we should short-term fix SERV to treat WFI as a nop and long term add proper support since it's a highly useful instruction for the kind of deeply embedded use cases that SERV intends to serve.

Thread 133 (2024-08-20):

mbedTLS on SERV

m42uko, 2024-08-20:
Hi,

I am currently trying to evaluate the performance of doing some crypto on SERV, but I'm running into some issues with Zephyr on SERV.

I wrote the attached example (main.c) that just initializes the RSA library according to their example, and then prints a string in a loop (no actual en-/decryption happens yet).

Yet, when I run the example (both on real HW and in simulation through fusesoc+verilator), the entire system hangs indefinitely (real HW) or resets (sim). If you remove the mbedtls init calls, the loop runs fine.

I have been trying to troubleshoot this a bit myself already, but I was hoping you might have some more experience analyzing these issues.

I attached the following files: [rsa-test-zephyr-serv.zip](https://github.com/user-attachments/files/16678149/rsa-test-zephyr-serv.zip)
* main.c: My test program (don't forget to enable the mbedtls RSA + entropy configs)
* log.txt: Output from verilator
* rsa-test-zephyr-serv.hex: The hex file I tested with
* run.sh: My run command for the simulation
* rsa-test-zephyr-serv.tar.xz: the entire application directory for zephyr (including configs and build results that produced the described output)

Let me know if you have any ideas on how to approach this / if you find out anything. Thank you for your help!

PS: I have not yet tried running the example program on any other RISC-V target. That's still on my TODO list.

olofk, 2024-08-23:
I haven't found time to look at this issue, but I did just fix an issue that made the regression tests fail. Probably unrelated, but could be worth trying with the latest git version.

Also, during my debugging sessions, I have develeoped some rudimentary tools that can make life slightly easier.

On the trace branch, I have added a WIP tracing module that shows register values and what opcode that was just executed. This makes things slightly easier to follow when doing waveform debugging.

You can also switch on the --trace_pc switch for simulations. This will generate a `trace.bin` that contains the PC trace. Together with [this questionable python hack](https://github.com/user-attachments/files/16727983/trays.tar.gz) you can do more analysis of what the CPU is doing. By default it will generate a trace with annotations of all jumps if you run it with `python trays.py /path/to/elf/file /path/to/trace.bin`

Another thing I typically do is to take the assembler listing of the program you want to run and check for illegal instructions or attempted accesses to unimplemented CSR registers. To save size, SERV has zero protection from these things and will happily try to execute instructions that it doesn't have the slightest clue about how to actually run. Looking quickly at the file you sent me, there is a read from mhartid. That might be totally fine, but worth taking an extra look at. I also see a wfi instruction + a couple of zext.b (which a quick googling tells me is the same as andi??) that could be wort investigating.

m42uko, 2024-09-10:
I didn't have much time to work on this, but I at least looked at your suggestions.

**1. `mhartid` and `wfi`**

There is only one access to `mhartid`, and it's conveniently in the same block as the `wfi`: The bootup section for unused cores (which we should never hit):
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

I'm pretty sure everything here is fine as we only have one CPU core, and even if the read from `mhartid` returned a core other than core 0, I'd expect a more severe error than a crash late in the program.

**2. `zext.b`**

I looked at the disassembly. `zext.b` produces the same assembly code as an `andi` with immediate `255`.

**3. Your latest updates**

I pulled the latest `main` branch today, and it sadly does not fix the issue.

**.**

I hope I'll have some more time to look into this in the upcoming days, but no promises :/

m42uko, 2024-12-19:
For anyone wondering, and for me to confirm that this is not a problem with SERV, here's what the problem was: I ran out of stack memory in the main thread and overwrote critical sections of OS memory. Doh!

The solution is to either increase the stack memory for the main/init process in the .config, or to create a second thread with more stack memory. Here's my working example utilizing the second method: [decrypt.zip](https://github.com/user-attachments/files/18193706/decrypt.zip) Takes about 25 minutes to decrypt 128 bytes (@25 MHz core clock), but it works :D

olofk, 2024-12-19:
Very cool. Thanks for sharing.

And that exact problem of running out of stack space has happened to me as well. It's an absolute pain to debug and looks really similar to a hardware bug. Would be nice to have some better way to detect this problem, at least in simulation.

Closed 2024-11-08.

Thread 140 (2024-12-04):

Is it possible to set the processing width with the "width"/"W" parameter?

BLangOS, 2024-12-04:
In the servant module there is a parameter "with" which is mapped to the parameter "W" of the serv_top module.
As far as I understand this parameter, it can be used to change the internal processing width of the serv-processor.
I have therefore tried to change the parameter to 2 or 4 in order to process 2 or 4 bits per clock cycle. However, I received warnings from yosys that the synthesis was resizing vectors, e.g:
“Warning: Resizing cell port $paramod$3eec962ce36018ce51e96f0857ef22d18d21aa80\serv_top.bufreg2.o_q from 2 bits to 1 bits.”
Further warnings reported that inputs are not connected, e.g:
“Warning: Wire servant.\cpu.cpu.state.o_cnt [0] is used but has no driver.”
Is it possible to change the processing width of the processor or does the “width” parameter have a different purpose?
Many thanks for more information about this parameter.

olofk, 2025-01-09:
Yes and no. There is ongoing work to make SERV support several widths but it's not complete yet. There are a couple of more files that need to be fixed. In the meantime, you can try the 4-bit version here https://github.com/olofk/qerv which uses most of the files from SERV but contains a few 4-bit specific ones.

Thread 142 (2024-12-15):

Threads are not preempted?

m42uko, 2024-12-15:
This is another one where I'm not sure whether this is a problem with SERV, or whether I'm not understanding something fundamental about Zephyr, but my threads don't get preempted, only cooperative multithreading is possible.

I modified the `hello_world` example to have the following main.c:

```c
#include <stdio.h>
#include <zephyr/kernel.h>

#define PRIORITY 7
#define STACKSIZE (256)

int main(void)
{
	while (1) {
		printf("Hello World! %s\n", CONFIG_BOARD_TARGET);
		k_msleep(1);
	}
	return 0;
}

int test_thread(void)
{
	while (1) {
		printf("Test thread\n");
		k_msleep(1);
	}
	return 0;
}

K_THREAD_DEFINE(test_thread_id, STACKSIZE, test_thread, NULL, NULL, NULL,
		PRIORITY, 0, 0);
```

When I run this, everything looks fine:

```
(.venv) user@3ce4f3685fd5:~/projects/fpga/serv_mainline/0TESTING (feature/zephyr-4.0.0)$ fusesoc run --target=verilator_tb servant --uart_baudrate=57600 --firmware=zephyr/samples/hello_world/hello.hex --memsize=65535
INFO: Preparing ::serv:1.3.0
INFO: Preparing ::servile:1.3.0
INFO: Preparing ::servant:1.3.0
make: Nothing to be done for 'all'.
Loading RAM from /home/user/projects/fpga/serv_mainline/0TESTING/zephyr/samples/hello_world/hello.hex
*** Booting Zephyr OS build v4.0.0 ***
Hello World! service
Test thread
Hello World! service
Test thread
Hello World! service
Test thread
Hello World! service
Test thread
Hello World! service
Test thread
Hello World! service
Test thread
```

But when I go ahead now and comment out the k_msleep() in one of the processes, the other one is never scheduled again.

With msleep commented out in main:

```
(.venv) user@3ce4f3685fd5:~/projects/fpga/serv_mainline/0TESTING (feature/zephyr-4.0.0)$ fusesoc run --target=verilator_tb servant --uart_baudrate=57600 --firmware=zephyr/samples/hello_world/hello.hex --memsize=65535
INFO: Preparing ::serv:1.3.0
INFO: Preparing ::servile:1.3.0
INFO: Preparing ::servant:1.3.0
make: Nothing to be done for 'all'.
Loading RAM from /home/user/projects/fpga/serv_mainline/0TESTING/zephyr/samples/hello_world/hello.hex
*** Booting Zephyr OS build v4.0.0 ***
Hello World! service
Hello World! service
Hello World! service
Hello World! service
Hello World! service
Hello World! service
Hello World! service
Hello World! service
```

With msleep comment out in task:

```
(.venv) user@3ce4f3685fd5:~/projects/fpga/serv_mainline/0TESTING (feature/zephyr-4.0.0)$ fusesoc run --target=verilator_tb servant --uart_baudrate=57600 --firmware=zephyr/samples/hello_world/hello.hex --memsize=65535
INFO: Preparing ::serv:1.3.0
INFO: Preparing ::servile:1.3.0
INFO: Preparing ::servant:1.3.0
make: Nothing to be done for 'all'.
Loading RAM from /home/user/projects/fpga/serv_mainline/0TESTING/zephyr/samples/hello_world/hello.hex
*** Booting Zephyr OS build v4.0.0 ***
Hello World! service
Test thread
Test thread
Test thread
Test thread
Test thread
Test thread
Test thread
Test thread
Test thread
```

I checked that `PREEMPT_ENABLED=1` is selected in the config. Everything looks good there as far as I can tell. Also, removing the printf along with the msleep (just a silent loop) shows that the other thread is never scheduled (just to make sure that the many prints don't hide the less often scheduled print.)

Maybe you have some minutes to look into this as well. Thanks!
