olofk/serv/data/cmod_a7_35t.xdc

## 12 MHz Clock Signal
set_property -dict { PACKAGE_PIN L17   IOSTANDARD LVCMOS33 } [get_ports { i_clk }]; #IO_L12P_T1_MRCC_14 Sch=gclk
create_clock -add -name sys_clk_pin -period 83.33 -waveform {0 41.66} [get_ports { i_clk }];

## LEDs
set_property -dict { PACKAGE_PIN A17   IOSTANDARD LVCMOS33 } [get_ports { q }]; #IO_L12N_T1_MRCC_16 Sch=led[1]
#set_property -dict { PACKAGE_PIN C16   IOSTANDARD LVCMOS33 } [get_ports { q }]; #IO_L13P_T2_MRCC_16 Sch=led[2]

## UART
set_property -dict { PACKAGE_PIN J18   IOSTANDARD LVCMOS33 } [get_ports { o_uart_tx }]; #IO_L7N_T1_D10_14 Sch=uart_rxd_out
#set_property -dict { PACKAGE_PIN J17   IOSTANDARD LVCMOS33 } [get_ports { q  }]; #IO_L7P_T1_D09_14 Sch=uart_txd_in

set_property -dict { PACKAGE_PIN A18   IOSTANDARD LVCMOS33 } [get_ports { i_rst }]; #IO_L19N_T3_VREF_16 Sch=btn[0]

set_property CFGBVS VCCO [current_design]
set_property CONFIG_VOLTAGE 3.3 [current_design]
