olofk/serv/servant/servant_pf_clock_gen.v

`timescale 1 ns/100 ps

module servant_pf_clock_gen(
	input	wire	i_clk,
	output	wire	o_clk,
	output	reg		o_lock);

	// for documentation
	parameter refclk = 50;
	parameter frequency = 32;

	// PLL in internal Post-VCO Feedback mode
	localparam [11:0]	fbdiv = 12'b100111000000;	// 2496
	localparam [5:0]	rfdiv = 6'b011001;			// 25;
	localparam			vco = 4992;					// refclk * fbdiv / rfdiv;
	localparam [6:0]	odiv = 7'b0100111;			// vco / (4 * frequency);

	wire	gnd_net, vcc_net, pll_inst_0_clkint_0;
	wire nc0, nc1, nc2, nc3, nc4, nc5, nc6, nc7, nc8, nc9, nc10, nc11, nc12,
		nc13, nc14, nc15, nc16, nc17, nc18, nc19, nc20, nc21, nc22, nc23,
		nc24, nc25, nc26, nc27, nc28, nc29, nc30, nc31, nc32, nc33, nc34,
		nc35, nc36, nc37, nc38, nc39, nc40;

	VCC vcc_inst (.Y(vcc_net));
	GND gnd_inst (.Y(gnd_net));

	PLL #(
		.VCOFREQUENCY(vco),
		.DELAY_LINE_SIMULATION_MODE(""),
		.DATA_RATE(0.0),
		.FORMAL_NAME(""),
		.INTERFACE_NAME(""),
		.INTERFACE_LEVEL(3'b0),
		.SOFTRESET(1'b0),
		.SOFT_POWERDOWN_N(1'b1),
		.RFDIV_EN(1'b1),
		.OUT0_DIV_EN(1'b1),
		.OUT1_DIV_EN(1'b0),
		.OUT2_DIV_EN(1'b0),
		.OUT3_DIV_EN(1'b0),
		.SOFT_REF_CLK_SEL(1'b0),
		.RESET_ON_LOCK(1'b1),
		.BYPASS_CLK_SEL(4'b0),
		.BYPASS_GO_EN_N(1'b1),
		.BYPASS_PLL(4'b0),
		.BYPASS_OUT_DIVIDER(4'b0),
		.FF_REQUIRES_LOCK(1'b0),
		.FSE_N(1'b0),
		.FB_CLK_SEL_0(2'b00),
		.FB_CLK_SEL_1(1'b0),
		.RFDIV(rfdiv),
		.FRAC_EN(1'b0),
		.FRAC_DAC_EN(1'b0),
		.DIV0_RST_DELAY(3'b000),
		.DIV0_VAL(odiv),
		.DIV1_RST_DELAY(3'b0),
		.DIV1_VAL(7'b1),
		.DIV2_RST_DELAY(3'b0),
		.DIV2_VAL(7'b1),
		.DIV3_RST_DELAY(3'b0),
		.DIV3_VAL(7'b1),
		.DIV3_CLK_SEL(1'b0),
		.BW_INT_CTRL(2'b0),
		.BW_PROP_CTRL(2'b01),
		.IREF_EN(1'b1),
		.IREF_TOGGLE(1'b0),
		.LOCK_CNT(4'b1000),
		.DESKEW_CAL_CNT(3'b110),
		.DESKEW_CAL_EN(1'b1),
		.DESKEW_CAL_BYPASS(1'b0),
		.SYNC_REF_DIV_EN(1'b0),
		.SYNC_REF_DIV_EN_2(1'b0),
		.OUT0_PHASE_SEL(3'b000),
		.OUT1_PHASE_SEL(3'b0),
		.OUT2_PHASE_SEL(3'b0),
		.OUT3_PHASE_SEL(3'b0),
		.SOFT_LOAD_PHASE_N(1'b1),
		.SSM_DIV_VAL(6'b1),
		.FB_FRAC_VAL(24'b0),
		.SSM_SPREAD_MODE(1'b0),
		.SSM_MODULATION(5'b00101),
		.FB_INT_VAL(fbdiv),
		.SSM_EN_N(1'b1),
		.SSM_EXT_WAVE_EN(2'b0),
		.SSM_EXT_WAVE_MAX_ADDR(8'b0),
		.SSM_RANDOM_EN(1'b0),
		.SSM_RANDOM_PATTERN_SEL(3'b0),
		.CDMUX0_SEL(2'b0),
		.CDMUX1_SEL(1'b1),
		.CDMUX2_SEL(1'b0),
		.CDELAY0_SEL(8'b0),
		.CDELAY0_EN(1'b0),
		.DRI_EN(1'b1)
	) pll_inst_0 (
		.LOCK(o_lock),
		.SSCG_WAVE_TABLE_ADDR({
			nc0, nc1, nc2, nc3, nc4, nc5, nc6, nc7
		}),
		.DELAY_LINE_OUT_OF_RANGE(),
		.POWERDOWN_N(vcc_net),
		.OUT0_EN(vcc_net),
		.OUT1_EN(gnd_net),
		.OUT2_EN(gnd_net),
		.OUT3_EN(gnd_net),
		.REF_CLK_SEL(gnd_net),
		.BYPASS_EN_N(vcc_net),
		.LOAD_PHASE_N(vcc_net),
		.SSCG_WAVE_TABLE({
			gnd_net, gnd_net, gnd_net, gnd_net, gnd_net, gnd_net, gnd_net,
			gnd_net
		}),
		.PHASE_DIRECTION(gnd_net),
		.PHASE_ROTATE(gnd_net),
		.PHASE_OUT0_SEL(gnd_net),
		.PHASE_OUT1_SEL(gnd_net),
		.PHASE_OUT2_SEL(gnd_net),
		.PHASE_OUT3_SEL(gnd_net),
		.DELAY_LINE_MOVE(gnd_net),
		.DELAY_LINE_DIRECTION(gnd_net),
		.DELAY_LINE_WIDE(gnd_net),
		.DELAY_LINE_LOAD(vcc_net),
		.REFCLK_SYNC_EN(gnd_net),
		.REF_CLK_0(i_clk),
		.REF_CLK_1(gnd_net),
		.FB_CLK(gnd_net),
		.OUT0(pll_inst_0_clkint_0),
		.OUT1(),
		.OUT2(),
		.OUT3(),
		.DRI_CLK(gnd_net),
		.DRI_CTRL({
			gnd_net, gnd_net, gnd_net, gnd_net, gnd_net, gnd_net, gnd_net,
			gnd_net, gnd_net, gnd_net, gnd_net
		}),
		.DRI_WDATA({
			gnd_net, gnd_net, gnd_net, gnd_net, gnd_net, gnd_net, gnd_net,
			gnd_net, gnd_net, gnd_net, gnd_net, gnd_net, gnd_net, gnd_net,
			gnd_net, gnd_net, gnd_net, gnd_net, gnd_net, gnd_net, gnd_net,
			gnd_net, gnd_net, gnd_net, gnd_net, gnd_net, gnd_net, gnd_net,
			gnd_net, gnd_net, gnd_net, gnd_net, gnd_net
		}),
		.DRI_ARST_N(vcc_net),
		.DRI_RDATA({
			nc8, nc9, nc10, nc11, nc12, nc13, nc14, nc15, nc16, nc17, nc18,
			nc19, nc20, nc21, nc22, nc23, nc24, nc25, nc26, nc27, nc28, nc29,
			nc30, nc31, nc32, nc33, nc34, nc35, nc36, nc37, nc38, nc39,
			nc40
		}),
		.DRI_INTERRUPT()
	);

	CLKINT clkint_0 (
		.A(pll_inst_0_clkint_0),
		.Y(o_clk)
	);

  endmodule
