olofk/serv/(commit log)

2018-11-17 Add explicit wire defs to ports
2018-11-18 Temporary hack to blink LED on tinyfpga BX
2018-11-19 Add UART decoder
2018-11-22 Addapt compliance_test printing to new signature format
2018-11-22 Add support for IceBreaker board
2018-11-26 First attempt att interrupt support
2018-11-26 Interrupts working. Adding philosophers example
2018-12-07 Syntax fixes to please Quartus
    [serv_csr.v]
2018-12-07 Syntax fixes to please Vivado
    [serv_clock_gen.v]
2018-12-11 Fix bugs and missing resets to pass formal
    [serv_alu.v, serv_ctrl.v, serv_decode.v, serv_mem_if.v, serv_top.v]
2018-12-13 Fix failing compliance tests
    [serv_decode.v, serv_mem_if.v, serv_top.v]
2019-03-25 Fix width mismatches to make code verilator clean
    [serv_alu.v, serv_bufreg.v, serv_clock_gen.v, serv_wrapper.v]
2019-06-07 Store CSR in RF RAM
    Since FPGA uses fixed-size RAM, it's better in most cases to store
    the CSR in unused memory positions in that RAM.
    Since the decoding is made more complex, the old register file
    implementation is kept around since that is more efficient when we
    don't want CSR and potentially when the FPGA support hardware
    shift registers.
    [serv_csr.v, serv_mpram.v, serv_top.v]
2019-06-24 Declare wires before use
2019-06-24 Refactor gpio/uart output in tb
2019-07-22 Fix typo in service reset signal
    [service.v]
2019-07-23 Add missing RVFI port
    [servant.v]
2019-08-25 Interrupt refactoring
2019-08-25 Replace wb_ram with servant_ram
    [servant.v, servant_ram.v]
2019-09-13 Mask rvfi_valid during reset release
    [serv_top.v]
2019-09-15 Avoid exposing funct3 from decode
    [serv_decode.v, serv_mem_if.v, serv_top.v]
2019-09-16 Simplify two-stage signalling
2019-09-26 rtl: Make compatible to Synopsys Design Compiler
    Synopysis DC has problems with forward references and initial
    statements. Fixed that for better compatibility.
    [serv_mpram.v, serv_top.v]
2019-09-26 Fix syntax error for o_take_branch
    [serv_decode.v]
2019-10-29 Ignore initial garbage in verilator UART decoder
2019-10-29 Bring back old immediate decoder
    This was originally thrown out since it was slow and cost too much
    resources. Due to other changes in the core, it is now cheaper
    than the other one
    [serv_bufreg.v, serv_ctrl.v, serv_decode.v, serv_top.v]
2019-11-04 Initialize state of verilator UART decoder
2019-11-10 README: argument to use blinky example instead of hello world is true for all boards
2019-11-19 Fix IRQ
    This contains a lot of fixes as IRQ support was broken on both
    RTL and zephyr side
    * Interrupts are now synced to instruction lifetimes
    * Interrupts are disabled on traps and mie is pushed to mpie
    * Zephyr applications regenerated from rewritten Zephyr port
    * Timer is 32-bit to avoid wrapping around too often
    * MEPC was not read properly from CSR storage
    [serv_csr.v, serv_state.v, serv_top.v, servant.v]
2019-11-20 Fix wen delays in rf
    [serv_mpram.v, serv_state.v]
2019-12-04 Fix compile errors with RISCV_FORMAL
    [serv_top.v]
2020-03-02 Add parameter to disable CSR/interrupts
    Also disables timer in servant if CSR/interrupts are disabled
2020-03-02 servant: Rename some wires
2020-03-25 Fix lint warnings when CSR is disabled
    [serv_rf_if.v, serv_rf_ram_if.v, serv_rf_top.v, serv_state.v, serv_top.v]
2020-03-27 Disable misalignment traps when CSR is disabled
    [serv_mem_if.v, serv_state.v, serv_top.v]
2020-04-23 Add Alhambra board to repo (#23)
    * Add Alhambra preliminary pcf
    * Add Alhambra to targets
    * Fix uart pin number
    * Update synth values
    * Fix clock values
    * Add Alhambra board to Readme
    * Make small explanation about Alhambra baud rate
2020-05-08 Update alhambra board (#29)
    * update pll out and add quotation marks to avoid parse error
    * Update Alhambra II baud rate
    * Update nextpnr freq option to 32
2020-05-26 Restore nettype to wire in toplevels
    This is needed to prevent breaking sources following SERV that
    don't handle nettype properly
    [serv_rf_top.v, serv_top.v]
2020-08-27 Add schematic for serv_decode
2020-09-28 serv on iCEstick HX1K FPGA Evaluation Board (#34)
    * Lattice iCEstick Evaluation Board PCF File
    * Added Lattice iCEstick Evaluation Board to servant fusesoc config
    * Fixed icestick pcf to use LED as q since default memfile is blinky
    * Updated README.md with iCEstick evaluation board details
2020-09-29 Fix double-defined result_lt wire
    [serv_alu.v]
2020-09-29 Set size of WITH_CSR to avoid Quartus warning
    [serv_state.v]
2020-09-30 servant: add AC701 board support
2020-10-02 servant: add iCESugar board support
2020-11-10 Remove unused reset input from serv_alu
    [serv_alu.v, serv_top.v]
2020-11-10 Add reset_strategy parameter
    The reset_strategy parameter controls how much reset to apply to
    SERV. It can be set to MINI for the default behaviour, or NONE to
    only apply reset where absolutely needed and rely on POR to clear
    FFs
    [serv_ctrl.v, serv_rf_ram_if.v, serv_rf_top.v, serv_state.v, serv_top.v, servant.v, serving.v]
2020-11-10 Syntax and reset fixes for ModelSim
    [serv_ctrl.v, serv_state.v, serv_top.v, servant.v, servant_ram.v, servant_tb.v, servant_timer.v]
2020-12-06 Reverse polarity of bufreg_hold signal
    [serv_state.v, serv_top.v]
2020-12-17 Update README.md
    Correct a typo in `fusesoc library add fusesoc_cores https://github.com/fusesoc/fusesoc_cores` to `fusesoc library add fusesoc_cores https://github.com/fusesoc/fusesoc-cores`
2021-02-03 add support for SoCKit development kit board
2021-02-07 Add support for DECA Max 10 board
2021-04-17 Fix RF we gating for RF width > 2
    [serv_rf_if.v]
2021-04-18 Remove unused wire cnt4
2021-04-22 Simulator-friendly cleanup of misalign_trap_sync
    [serv_state.v]
2021-06-10 Add instruction life cycle flowchart to doc
2021-06-10 Document one-stage instructions
2021-06-10 Add timing diagram for interrupts and ecall/ebreak
2021-06-28 Add support for Nandland Go Board
2021-06-28 Move to board-specific top-level and file set
2021-06-28 Wire up servant.q output to both LED1 and UART TX
2021-08-15 Add support for EBAZ4205 'Development' Board
    References:
    - https://github.com/fusesoc/blinky/pull/68/files (EBAZ4205 blinky)
    - https://github.com/fusesoc/blinky#ebaz4205-development-board
    - Existing 'arty_a7_35t' example
    This PR also cleans up a bunch of whitespace issues (no functional
    change).
    [ebaz4205.xdc, servix_ebaz4205.v, servix_ebaz4205_clock_gen.v]
2021-08-27 Add reset for new_irq register
    [serv_csr.v, serv_top.v]
2021-08-27 Fix signedness bug on immediates
    The sign bit on immediates relied on the value of csr_imm_en from
    the previous instruction. This fixes by gating with csr_imm_en
    after it has been latched instead of before
    [serv_immdec.v]
2021-08-27 Properly reset stage_two_req signal
    [serv_state.v]
2021-08-27 Add missing reset on cnt_done
    [serv_state.v]
2021-08-27 Avoid enabling bufreg before instruction is decoded
    [serv_state.v]
2021-09-27 Avoid printing directly in do_uart
    [servant_tb.cpp]
2021-10-05 Replace mem_op with dedicated control signals
    [serv_decode.v, serv_mem_if.v, serv_rf_if.v, serv_state.v, serv_top.v]
2021-12-28 Add missing gate on mem_rd with CSR disabled
    [serv_rf_if.v]
2022-01-11 chameleon96 board support added (#74)
    * chameleon96 board added
2022-01-13 added board_device_index : 2 to chameleon96 for programming
2022-02-09 Add reset for mie_mtie
    [serv_csr.v]
2022-05-17 Nexys 2 Board support
    Added nexys 2 target support for servant
2022-06-13 Add Alinx AX309 board as a target
    Running at 32MHz with 115200 baud rate UART (using the on-board RS232)
2022-06-13 Add description for AX309 board target
2022-07-25 privilege tests fixed for rv32i
    [serv_state.v, serv_top.v]
2022-10-13 Add ICE-V Wireless support
2022-10-16 Add reset input for Arty A7 target
    [arty_a7_35t.xdc, servix.v, servix_clock_gen.v]
2022-12-25 Deleted old compliance framework
2022-12-25 Update Compliance testing framework
2023-04-30 Migrate lint, nexys_a7, tinyfpga_bx and verilator_tb targets to flow API
2023-05-17 Fix CMOD A7 servant target
    [cmod_a7_35t.xdc, servant_cmod_a7.v, servant_cmod_a7_clock_gen.v]
2023-06-21 Enable support for tickless timer driver
2023-07-12 Add PC tracing capability
    This adds the --trace_pc option to dump the PC after each instruction to a file
    called trace.bin
2023-10-31 Avoid releasing trap signal too early
    The trap signal is used my the mux in serv_rf_if to decide which
    registers to write to. If the trap signal is dropped too early,
    the destination address changes while the register is still being
    written to.
    [serv_csr.v, serv_state.v, serv_top.v]
2023-11-16 Used named generate statements
    Unnamed generate statements are not recommended and some tools throw
    warnings or errors for these.
    [serv_alu.v, serv_ctrl.v, serv_decode.v, serv_immdec.v, serv_rf_if.v, serv_rf_ram_if.v, serv_state.v, serv_top.v]
2023-11-17 Change timer wraparound behavior to be more useful
2023-12-11 Port to Zephyr v3.5.0 + Fix System Timer (#111)
    zephyr: Port to Zephyr v3.5.0
    [uart_bitbang.c]
2024-03-19 Make serv_state more simulator-friendly
    Refactor the counter generation code to avoid using combinatorial
    always statements that rely on an event happening at time 0. This
    make serv work with Icarus again.
    [serv_state.v]
2024-06-15 Add Servant support for Alchitry Au platform. fusesoc core show servant CORE INFO Name: ::servant:1.2.1 Description: <No description> Core root: fusesoc_libraries/serv Core file: servant.core Targets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
    Creating bitstream...
    Writing bitstream ./servix.bit...
    Writing bitstream ./servix.bin...
    Bitstream generation completed
    INFO: [Common 17-206] Exiting Vivado at Fri Jun 14 16:49:54 2024...
    Resources used
    fusesoc run --target=alchitry_au servant --uart_baudrate=57600 --memfile ./fusesoc_libraries/serv/sw/zephyr_hello.hex
    +----------------------------+------+-------+------------+-----------+-------+
    | Site Type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
2024-06-15 Add ECP5 evaluation board target
    Done by analogy with ulx3s target
2024-06-15 Adding support for DE1 SoC revF board for servant
2024-08-22 Set correct value of mstatus[mpp]
    The correct value of mstatus[mpp] for machine-mode is 11, but SERV
    had this set to 00. Changes in the regression test suite uncovered
    this error.
    [serv_csr.v, serv_state.v, serv_top.v]
2024-08-22 Avoid matching misa CSR as mstatus
    Reads from the (unimplemented) misa register matched mstatus which
    in turn caused garbage data to be written to other CSRs. Make the
    matching mask slightly stricter to avoid this particular issue.
    [serv_decode.v]
2024-10-17 Fix CSR width issues in debug module
    [serv_debug.v]
2024-11-19 Update cad-suite GH action
2024-11-19 Fix CSR write detection in debug module
    [serv_debug.v]
2025-03-18 Make right-shifts one cycle faster
    This allows removing the stage_two_req register as well.
2025-12-16 Switch GMM-7550 to Flow API
2026-02-12 Add iCESugar-nano board
    Follow the 6 steps to add support for a new target.
    Step 1: Locate input and output pins.
    Step 2: Add pin constraint file. This covers clock input, LED and UART
    output.
    Step 3: Create a clock generator. The chip has no internal clock
    generator so the external 12 MHz clock is used.
    Step 4: Add top level servant_ice40_cm36 which connects the one-wire
    output of servant to the LED pin.
    Step 5: Add fileset including the new top level and pin constraints.
    Step 6: Add target icesugar-nano.
2026-06-17 Fix pyparsing compatibility for FuseSoC 2.4.6+
2026-07-10 Fix zero register handling in servile_rf_mem_if module.
    [servile_rf_mem_if.v]
